abaffa/sol-1/hardware/board-images/20180803_121057.png

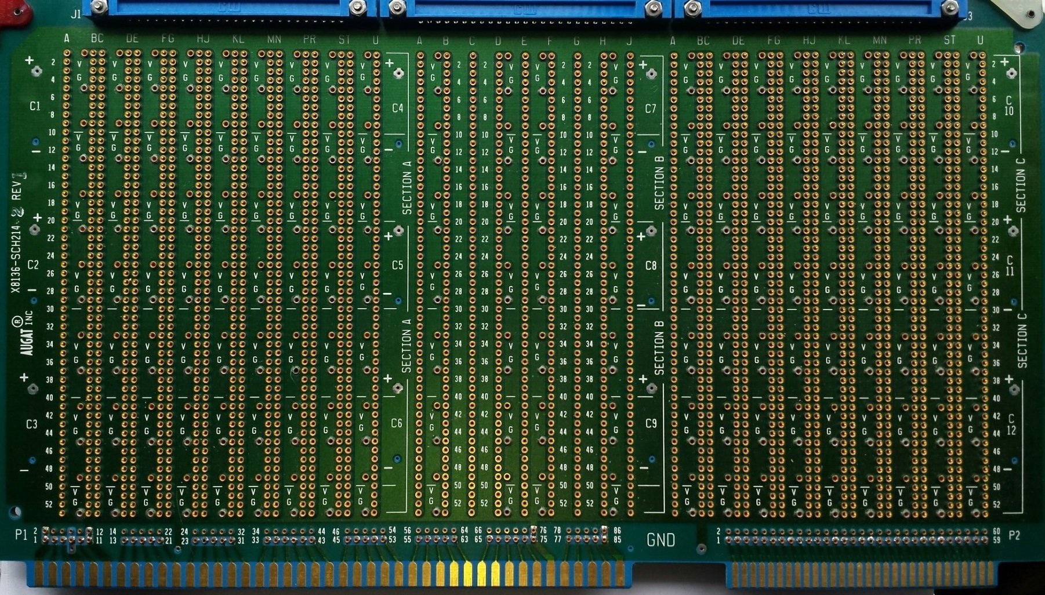
hardware/board-images/20180803_121057.png
