abaffa/sol-1/general_docs/TIL311_BOARD.png

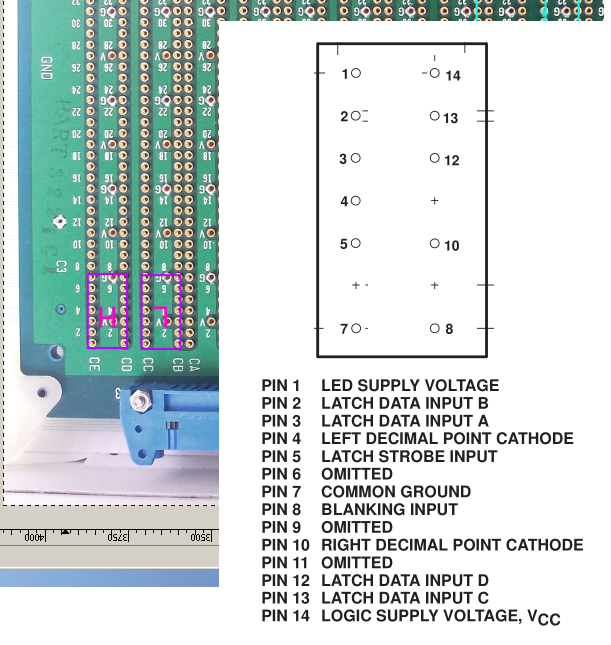
general_docs/TIL311_BOARD.png
