abaffa/sol-1/asciifull.gif

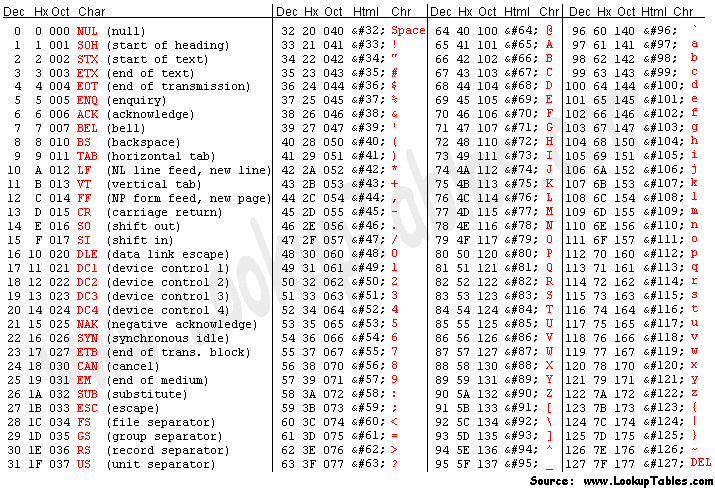
asciifull.gif
