abaffa/sol-1/general_docs/118781455_2642042719341005_6597366256445880285_o.jpg

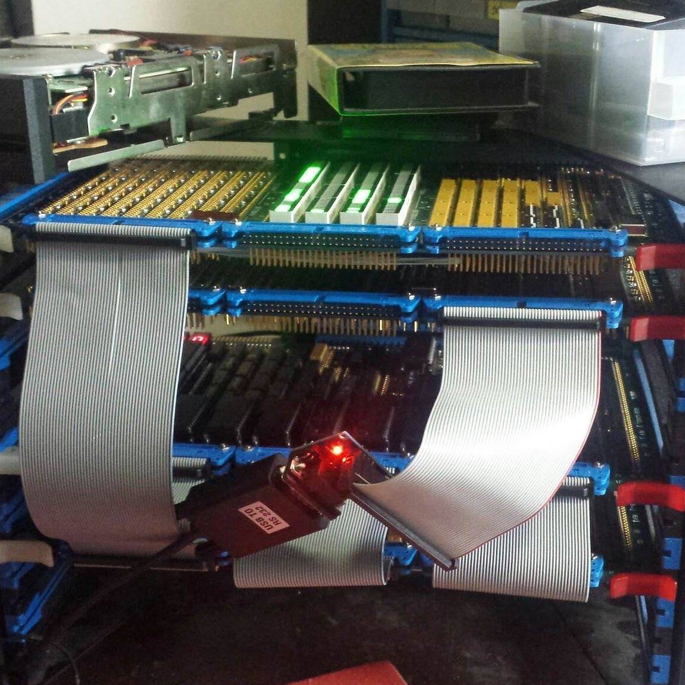
general_docs/118781455_2642042719341005_6597366256445880285_o.jpg
