abaffa/sol-1/general_docs/architecture.png

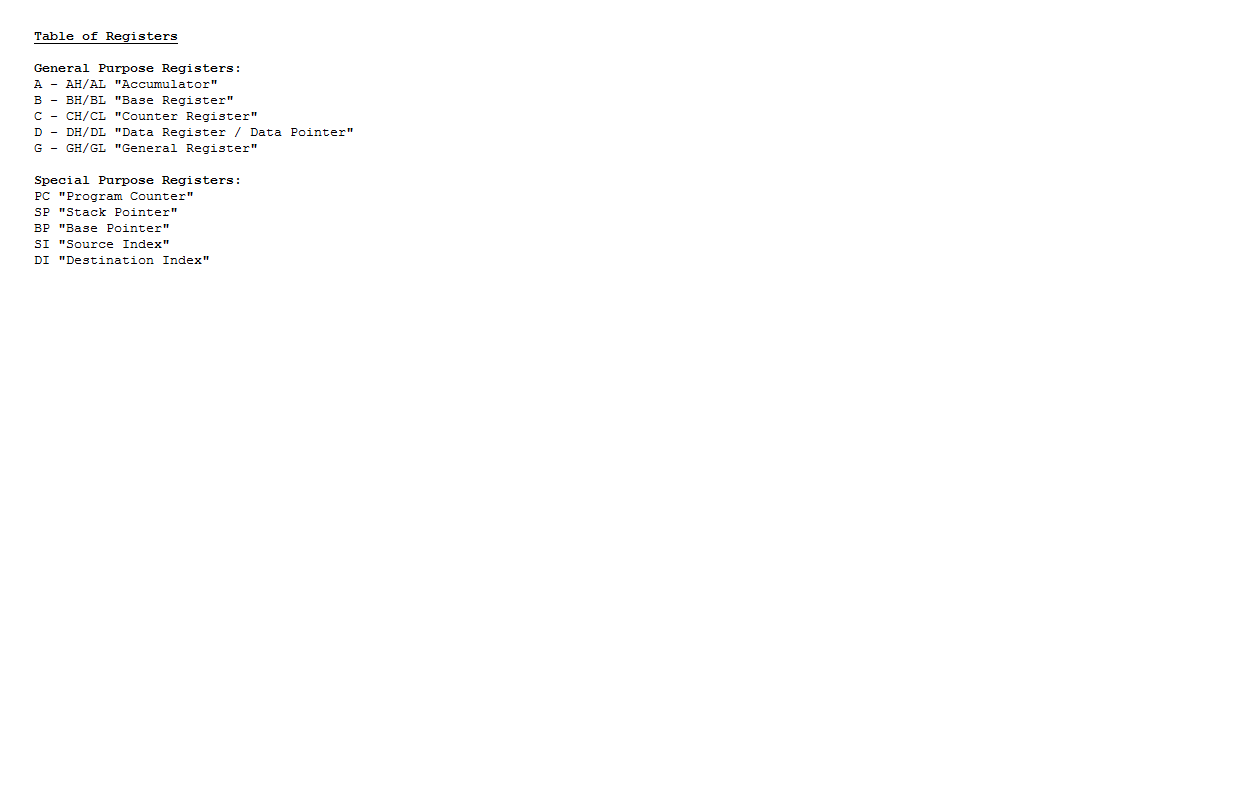
general_docs/architecture.png
