abaffa/sol-1/general_docs/crystal_pinout.png

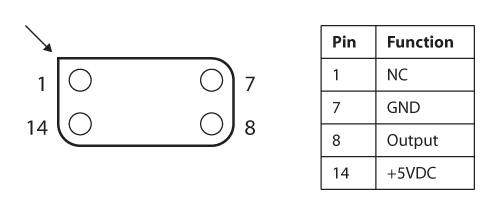
general_docs/crystal_pinout.png
