abaffa/sol-1/general_docs/division1.png

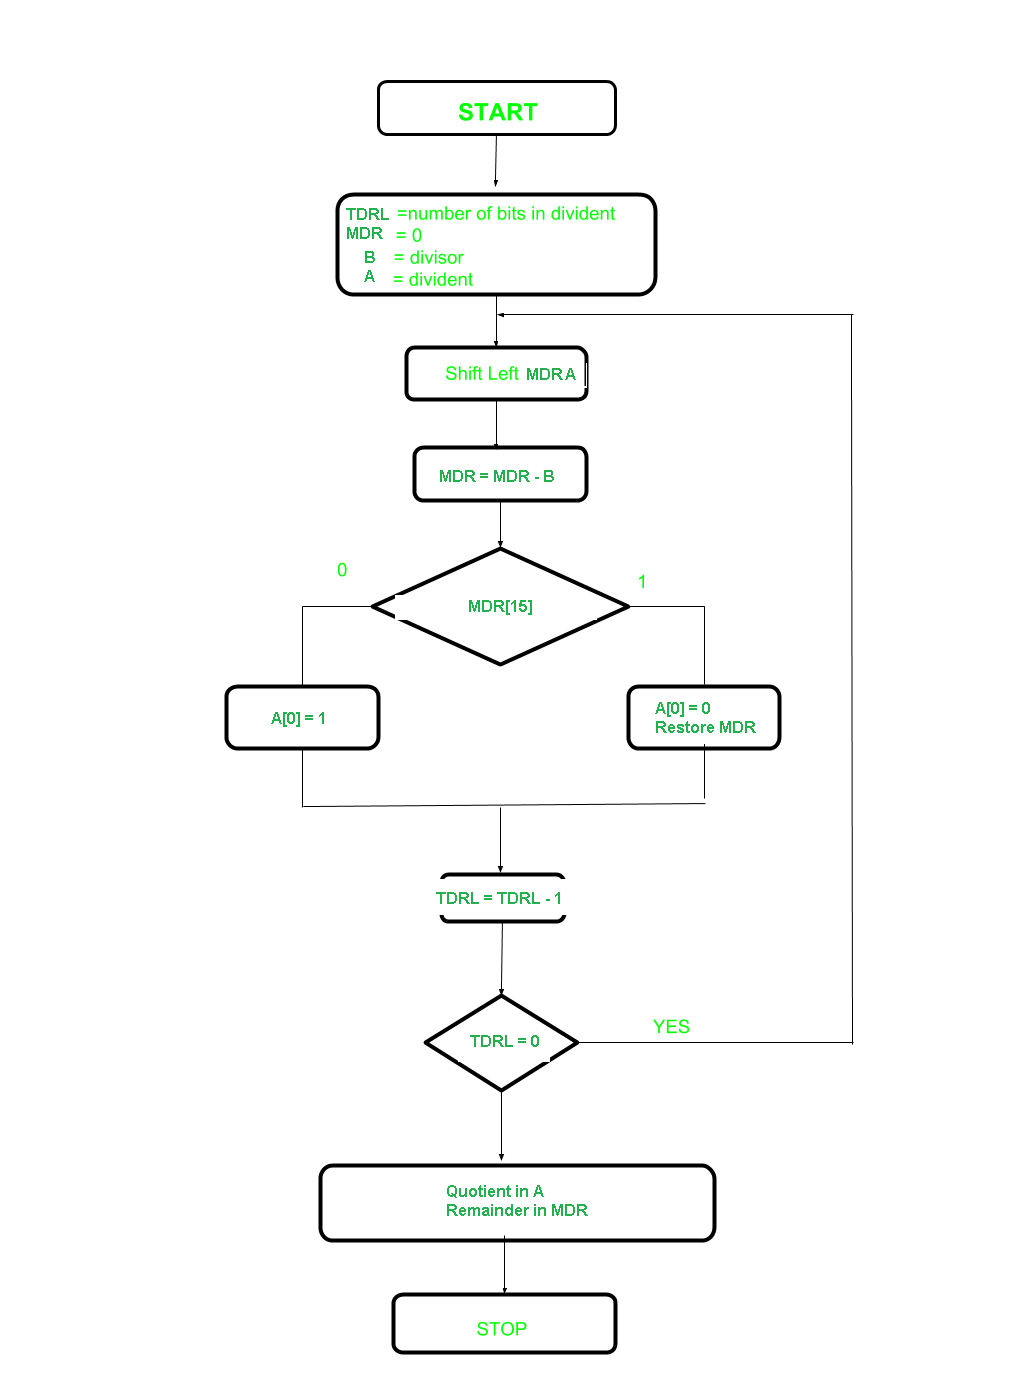
general_docs/division1.png
