abaffa/sol-1/general_docs/Introduction-to-NodeMCU-V3-2-1.png

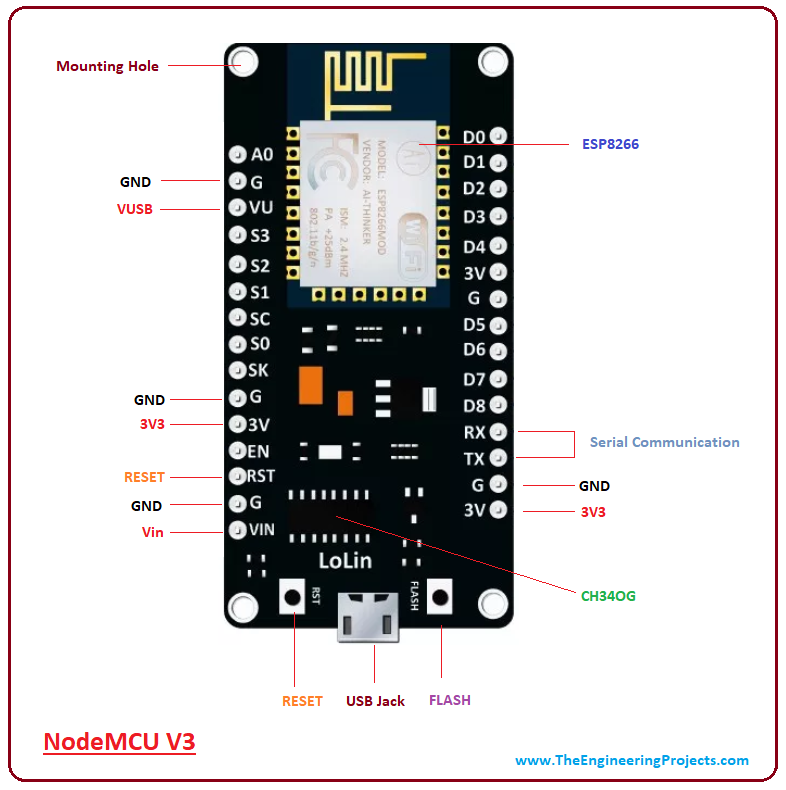
general_docs/Introduction-to-NodeMCU-V3-2-1.png
