abaffa/sol-1/general_docs/isa.jpg

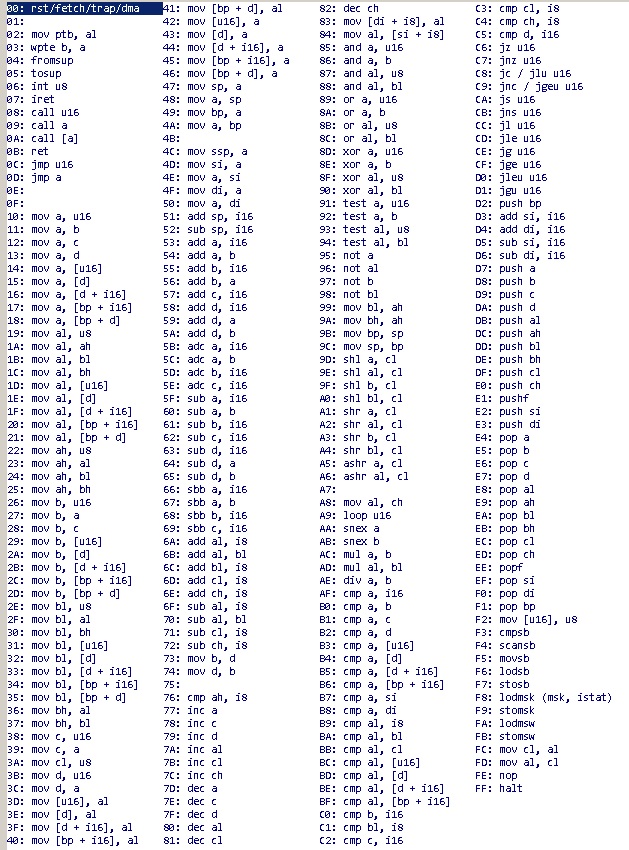
general_docs/isa.jpg
