abaffa/sol-1/general_docs/mc3-io-cf-sch.png

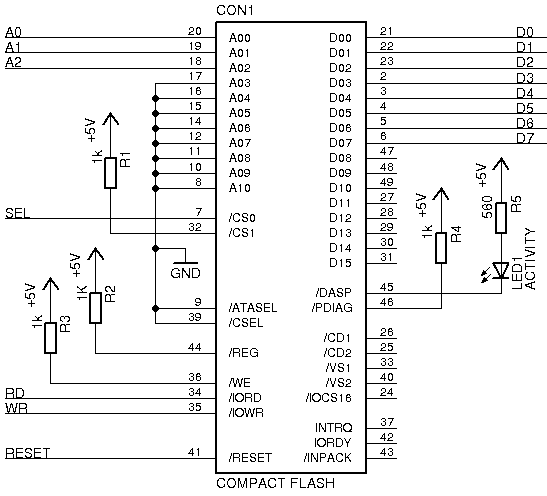
general_docs/mc3-io-cf-sch.png
