abaffa/sol-1/general_docs/PATA.gif

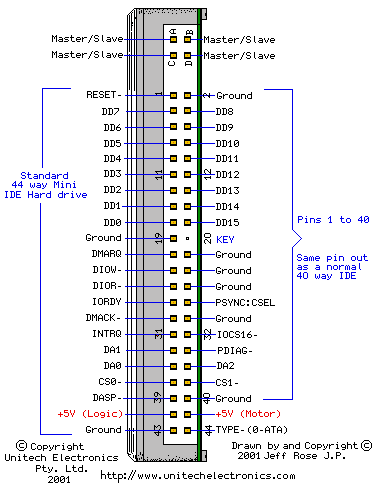
general_docs/PATA.gif
