abaffa/sol-1/general_docs/proxy.jpg

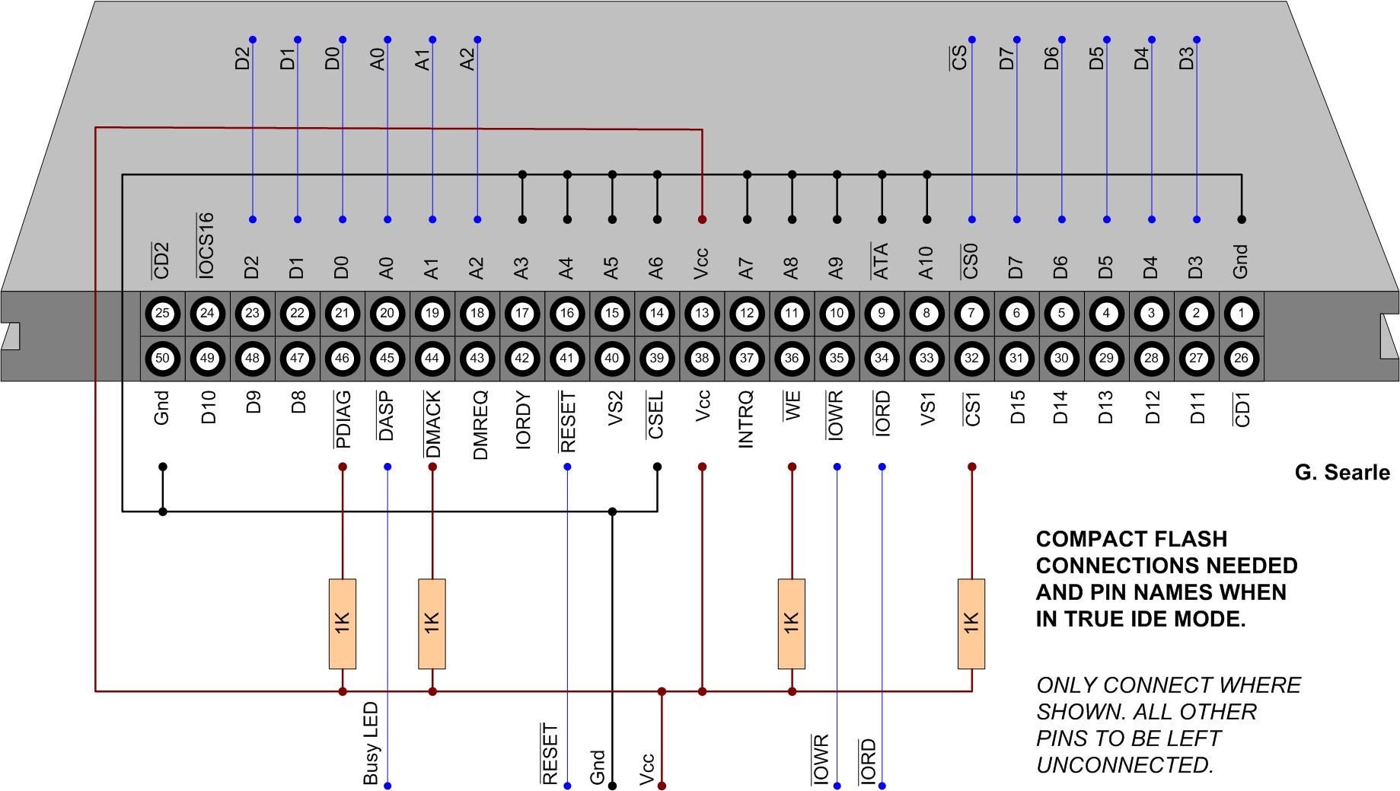
general_docs/proxy.jpg
