abaffa/sol-1/general_docs/qPHwh.jpg

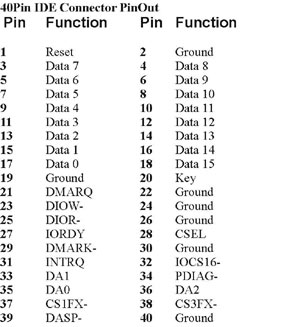
general_docs/qPHwh.jpg
