abaffa/sol-1/general_docs/sanyo_mainboard.jpg

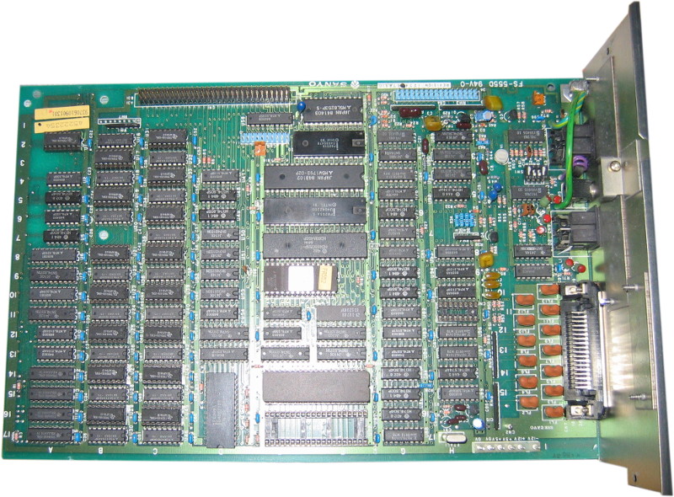
general_docs/sanyo_mainboard.jpg
