abaffa/sol-1/general_docs/TIL311.png

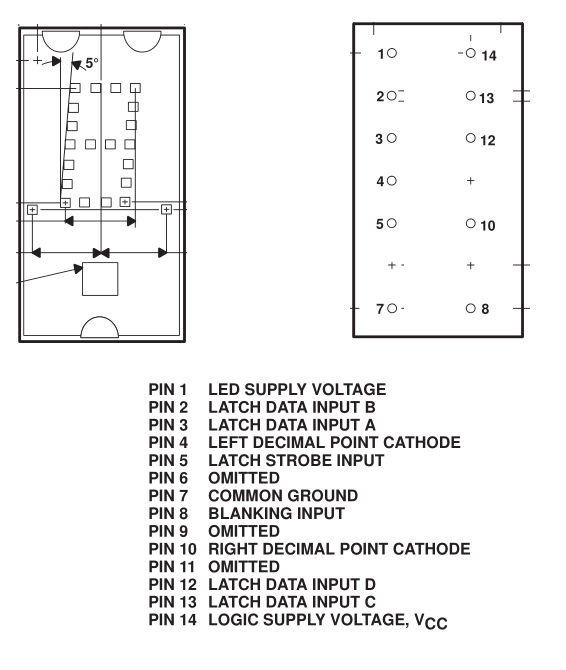
general_docs/TIL311.png
