abaffa/sol-1/general_docs/VIDEO/20060827t180501-videogen.png

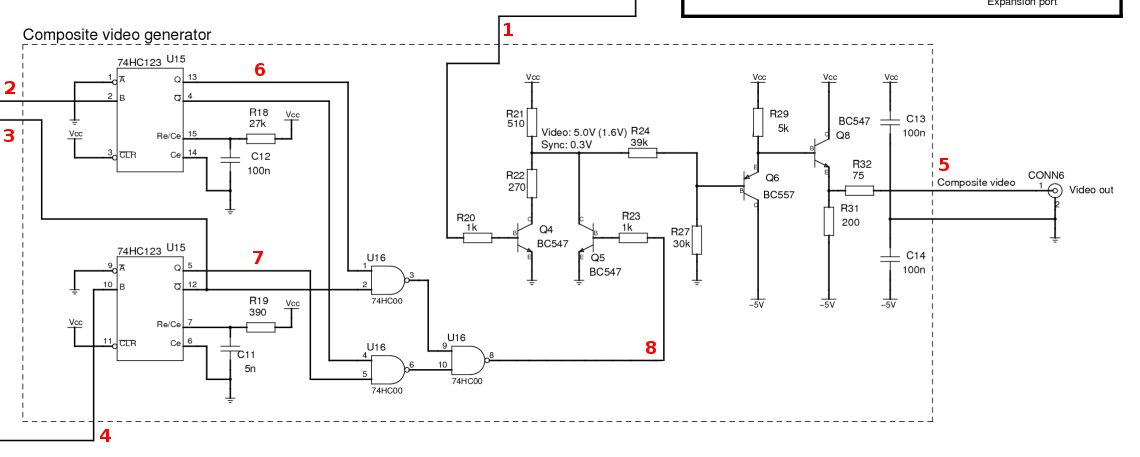
general_docs/VIDEO/20060827t180501-videogen.png
