abaffa/sol-1/general_docs/VIDEO/CBS-Color-FCC-Waveforms.jpg

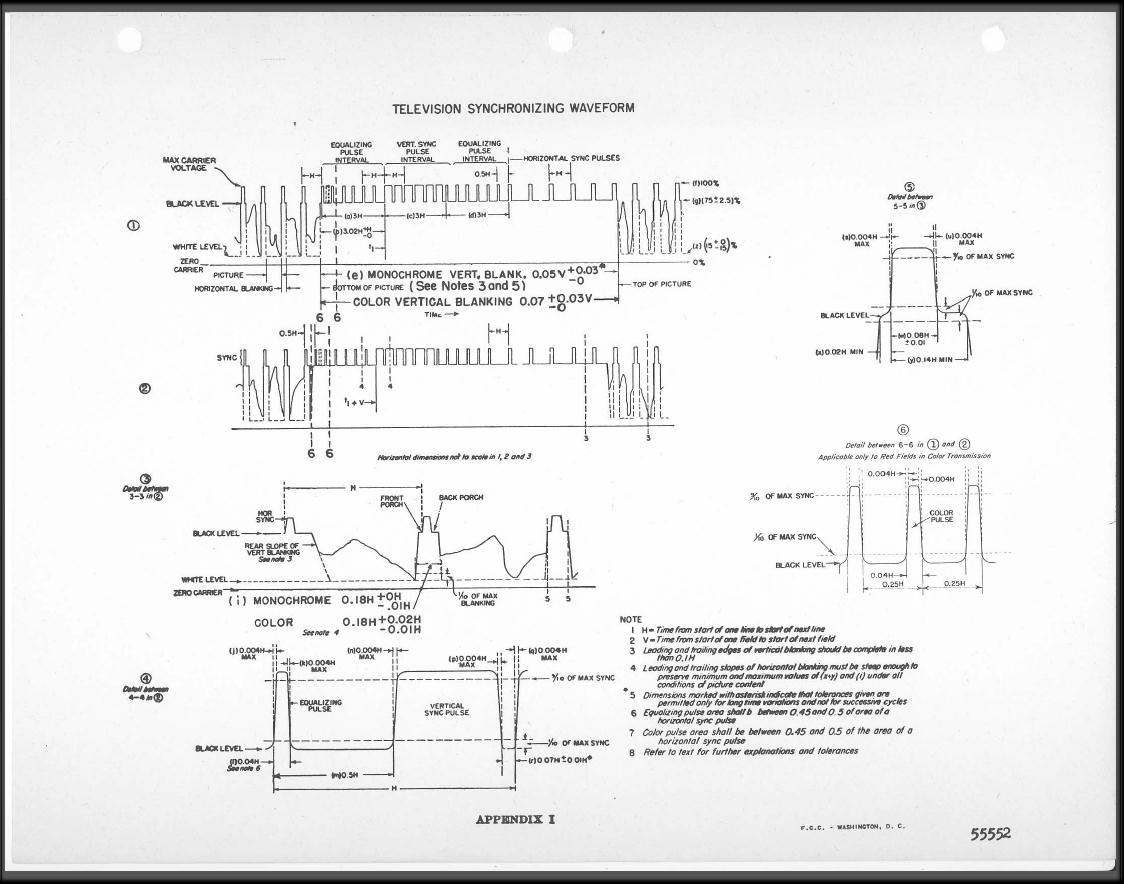
general_docs/VIDEO/CBS-Color-FCC-Waveforms.jpg
