abaffa/sol-1/general_docs/VIDEO/f19f8d1a1010.gif

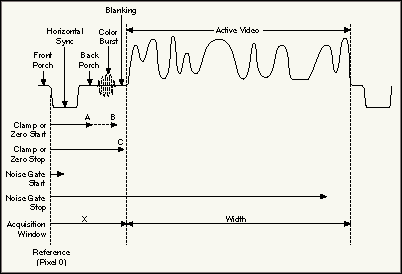
general_docs/VIDEO/f19f8d1a1010.gif
