abaffa/sol-1/general_docs/VIDEO/mc3-video-part1.png

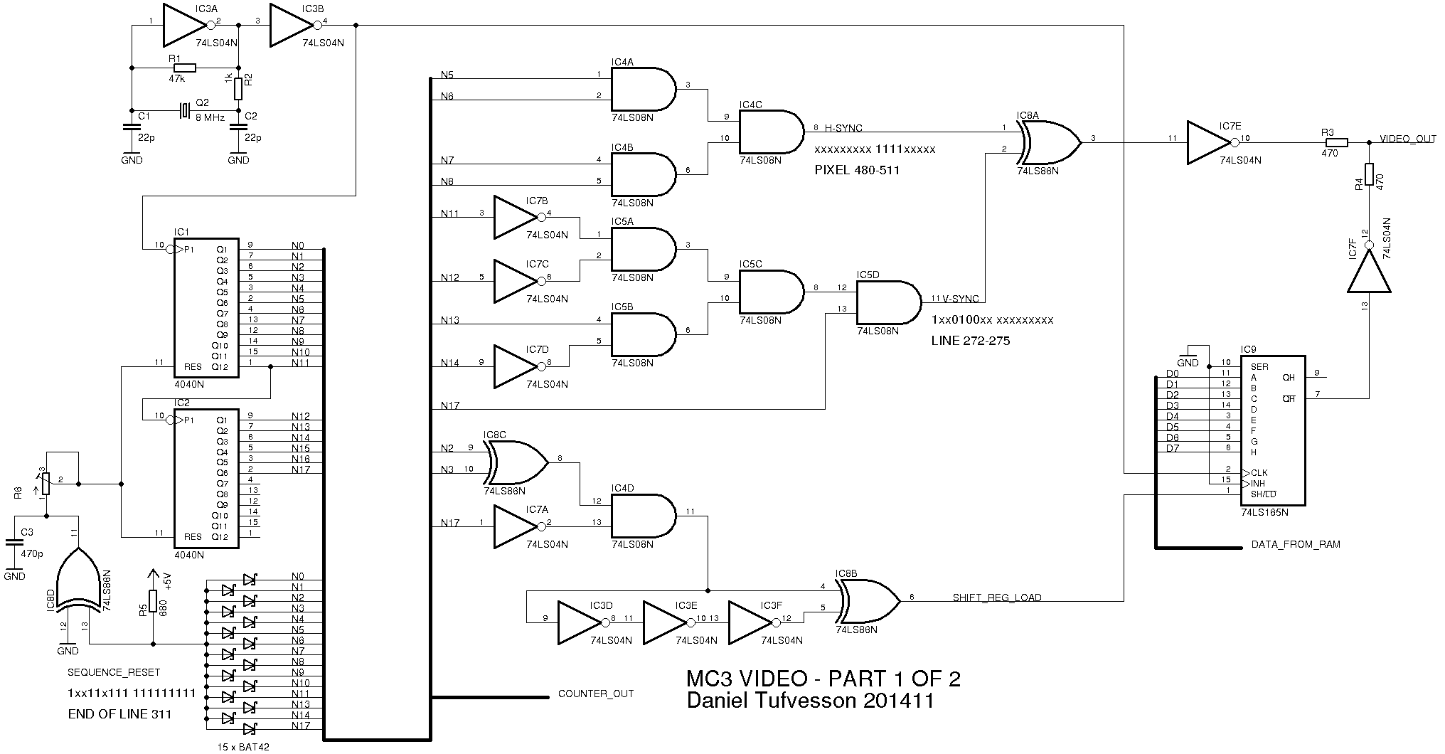
general_docs/VIDEO/mc3-video-part1.png
