abaffa/sol-1/general_docs/VIDEO/mc3-video-part2.png

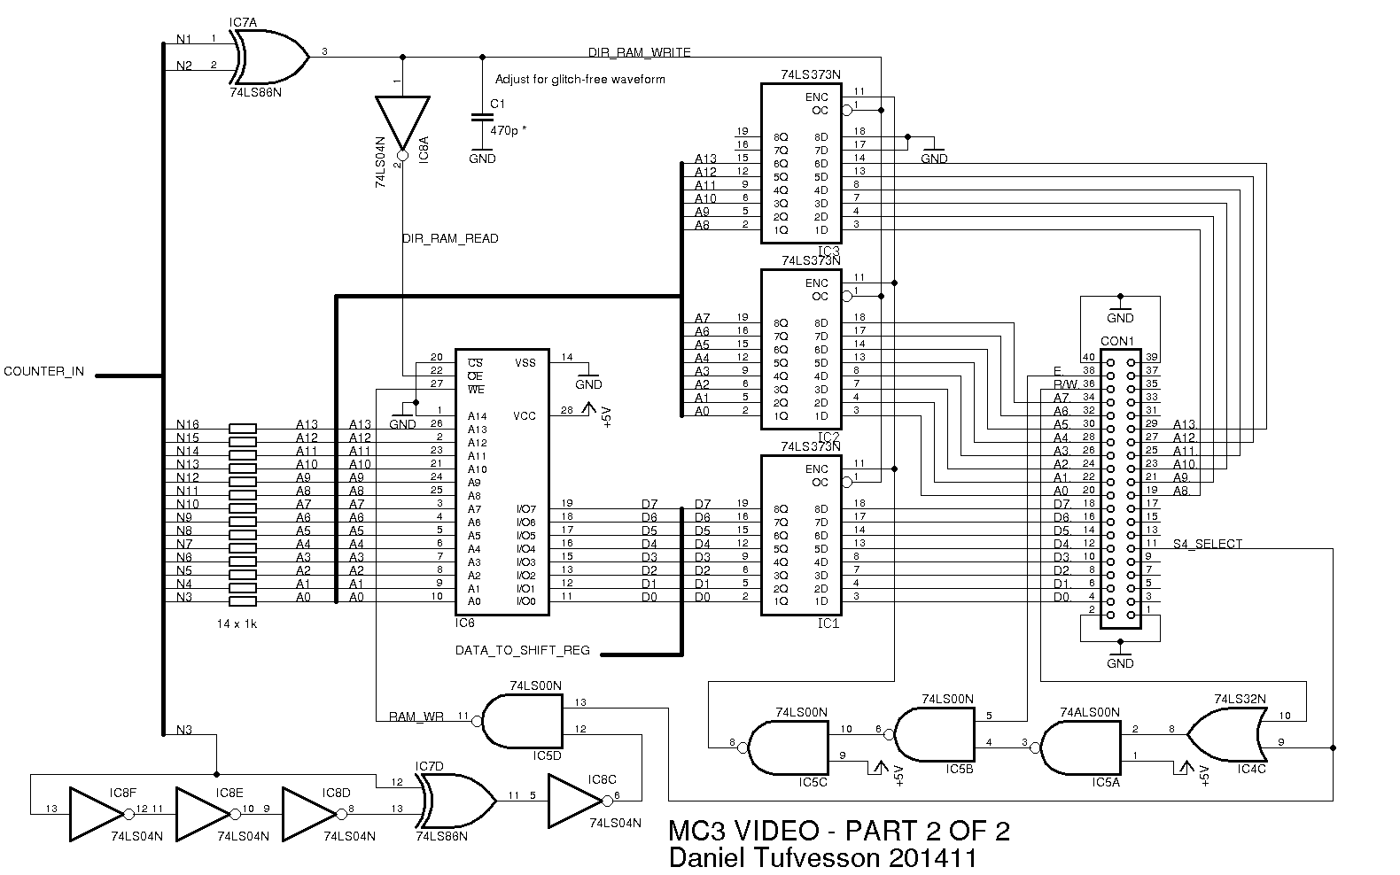
general_docs/VIDEO/mc3-video-part2.png
