abaffa/sol-1/general_docs/VIDEO/mc3-video-screen2.jpg

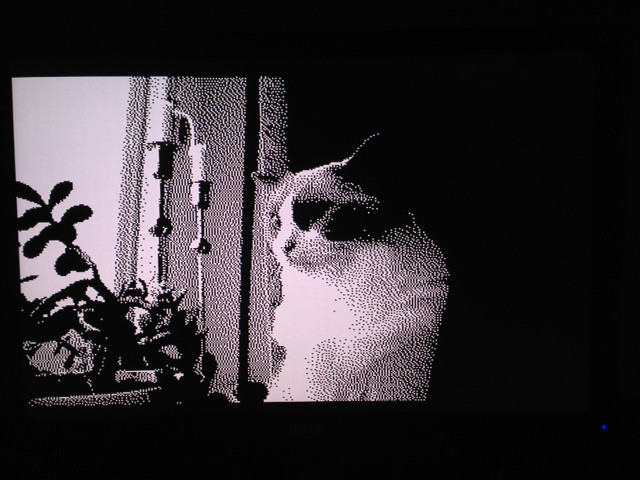
general_docs/VIDEO/mc3-video-screen2.jpg
