abaffa/sol-1/general_docs/VIDEO/RS-170A.gif

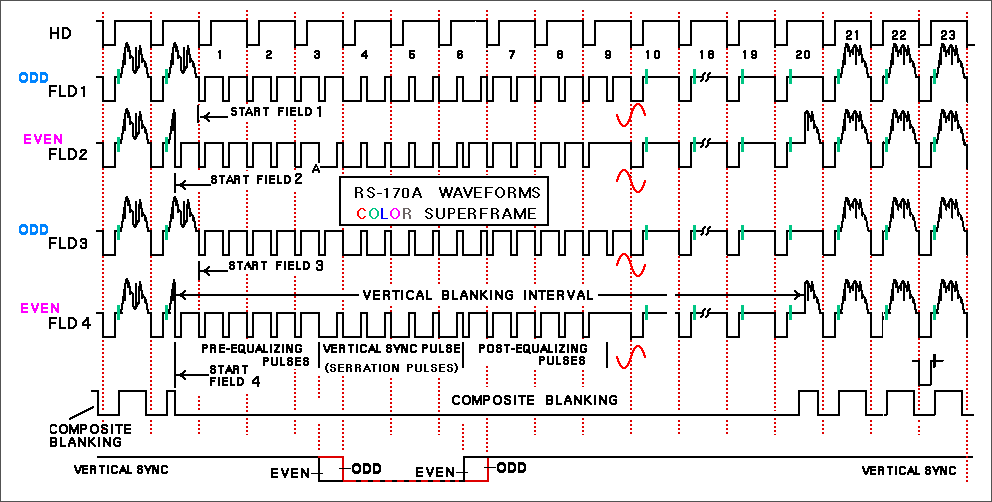
general_docs/VIDEO/RS-170A.gif
