abaffa/sol-1/general_docs/VIDEO/schema.jpg

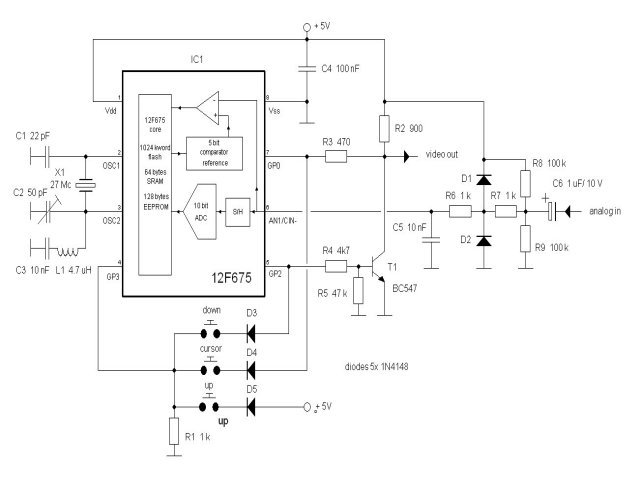
general_docs/VIDEO/schema.jpg
