abaffa/sol-1/general_docs/VIDEO/Timing_PAL_FrameSignal_Progressive.gif

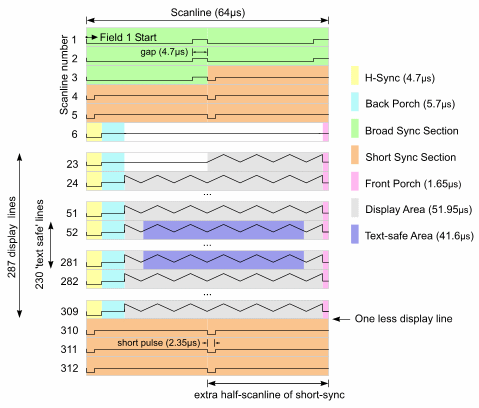
general_docs/VIDEO/Timing_PAL_FrameSignal_Progressive.gif
