abaffa/sol-1/general_docs/VIDEO/upload_2017-1-2_23-47-19.png

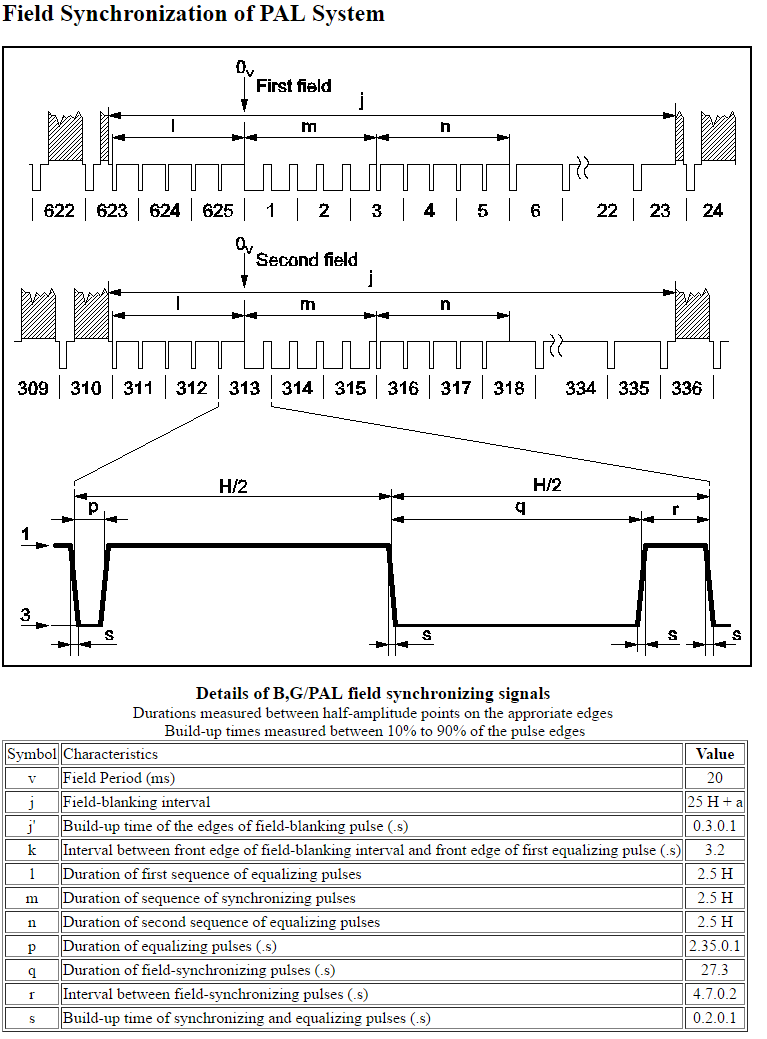
general_docs/VIDEO/upload_2017-1-2_23-47-19.png
