abaffa/sol-1/general_docs/VIDEO/vsync-full.png

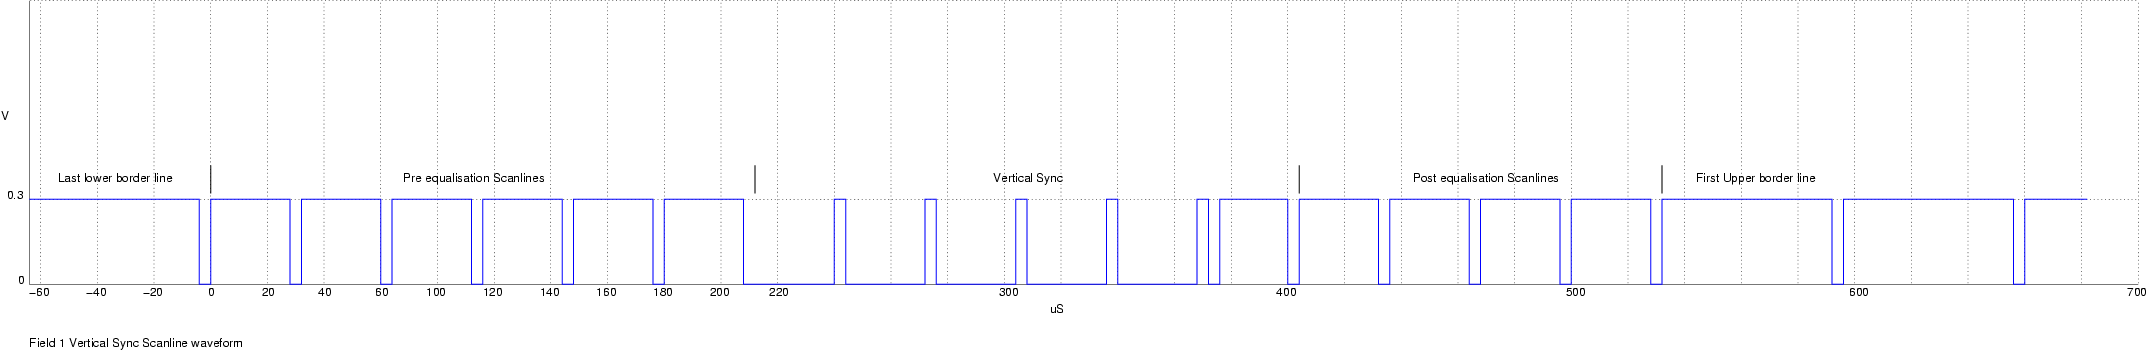
general_docs/VIDEO/vsync-full.png
