abaffa/sol-1/sol1_docs/CPU_Architecture.png

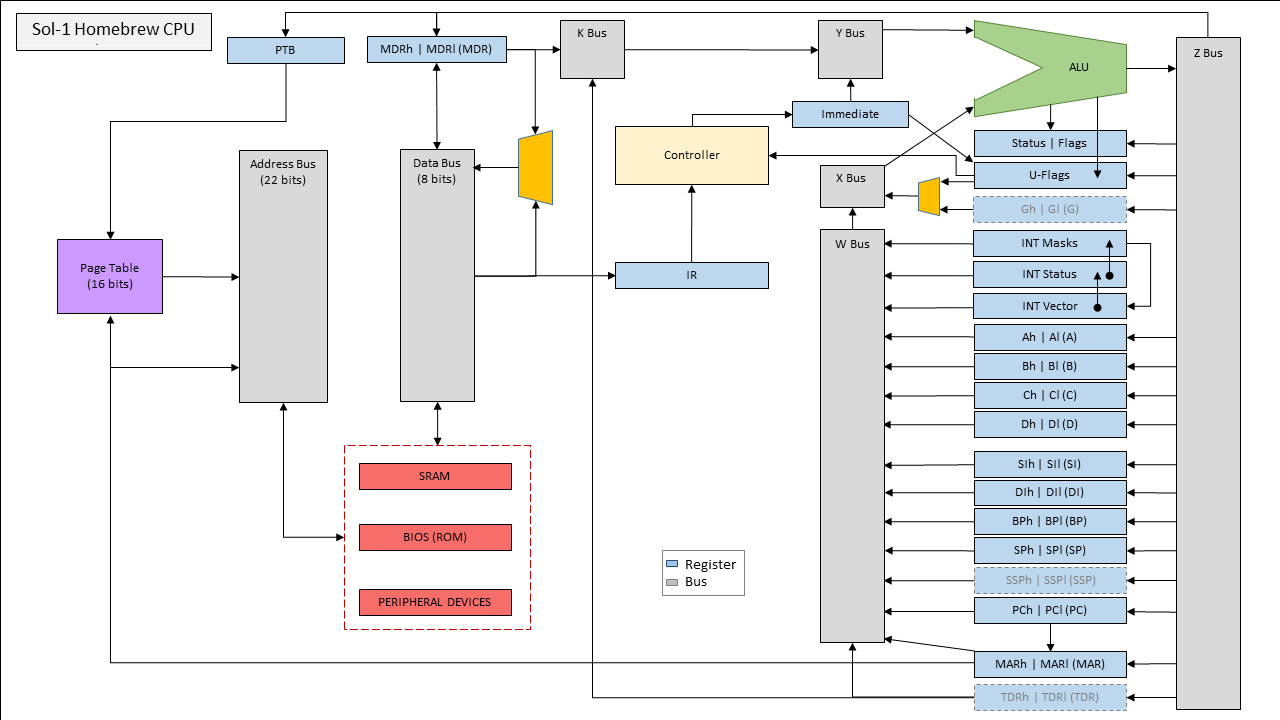
sol1_docs/CPU_Architecture.png
