abaffa/sol-1/sol1_docs/microcode_compiler.png

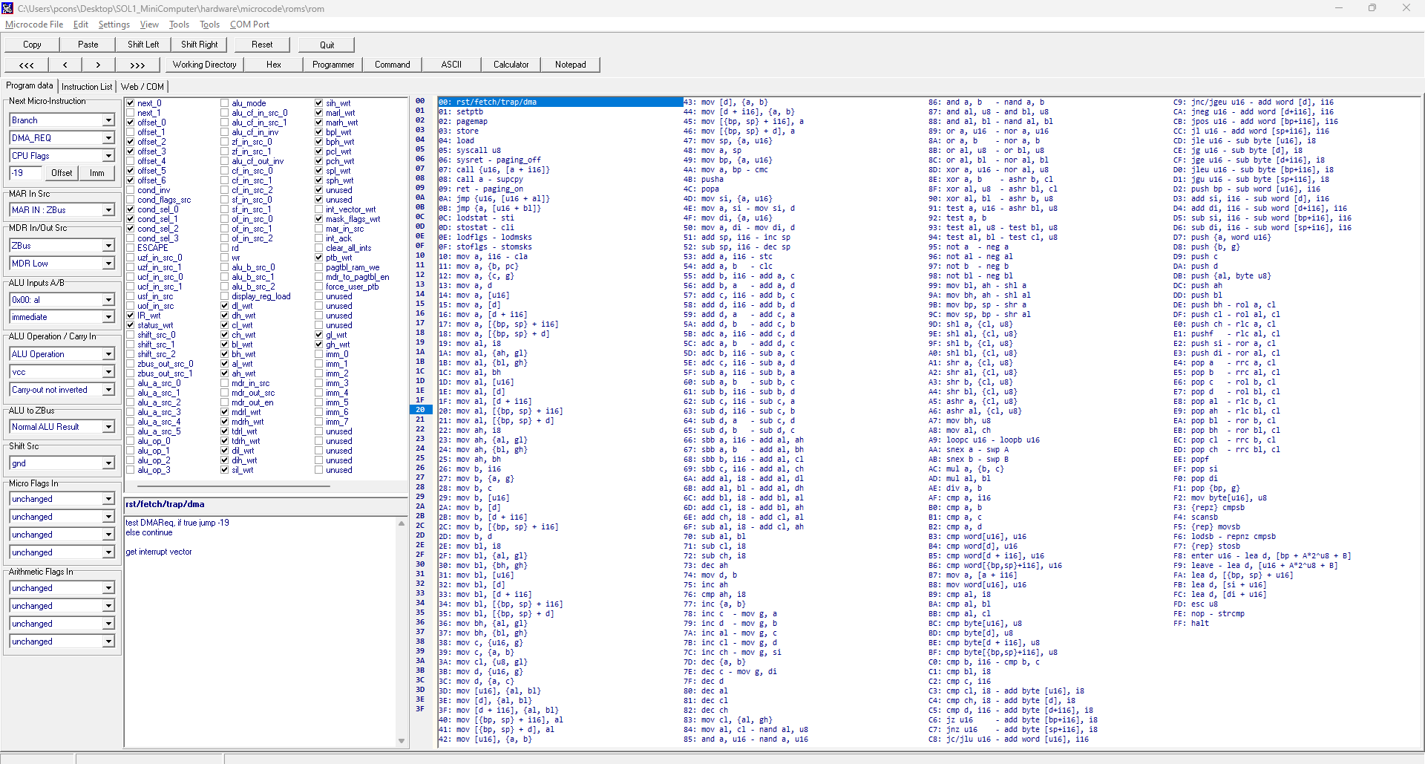
sol1_docs/microcode_compiler.png
