abaffa/sol-1/(list of files, cad)

Other CAD files:
ccompiler/a.obj
hardware/microcode/find.obj
hardware/microcode/simu.obj
hardware/microcode/sim.obj
hardware/microcode/unit_prompt.obj
hardware/microcode/class.obj
hardware/microcode/cf.obj
hardware/microcode/u_code_compiler_defs.obj
hardware/microcode/options.obj
