abaffa/sol-1/hardware/schematics/main.sch

## EAGLE design hardware/schematics/main.sch (2023-01-07)

Schematic: main.sch

Parts:
DIS1, DIS2, DIS3, DIS4, DIS5, DIS6: HTIL311A
FLAGS: 74273N; DIL20
IC1, IC13, IC15, IC39, IC90, IC98, IC104, IC112, IC114, IC118, IC121, IC122, IC125, IC127, IC142, IC147, IC195, IC206, IC256, IC341: 74LS257N; DIL16
IC2, IC3, IC5, IC6, IC9, IC12, IC14, IC16, IC20, IC23, IC30, IC41, IC42, IC44, IC53, IC56, IC61, IC62, IC67, IC68, IC69, IC71, IC80, IC81, IC82, IC84, IC85, IC86, IC87, IC88, IC89, IC130, IC133, IC141, IC144, IC152, IC160: 74LS151N; DIL16
IC4, IC26, IC65, IC70, IC72, IC97, IC120, IC161, IC163, IC185, IC207, IC209, IC211: 74LS244N; DIL20
IC7, IC24, IC54, IC96, IC128, IC129, IC131, IC132: 74157N; DIL16
IC8, IC19, IC28, IC31, IC48, IC57, IC66, IC99, IC101, IC102, IC106, IC109, IC110, IC117, IC123, IC157, IC158, IC159, IC162, IC165, IC166, IC169, IC171, IC172, IC177, IC178, IC183, IC184, IC198, IC204, IC210, IC245, IC260: 74LS377N; DIL20
IC10, IC11: 74S181N; DIL24-6
IC17, IC27, IC150, IC218, IC219, IC222, IC223, IC224, IC225, IC228, IC229, IC230: 74HC244N; DIL20
IC18, IC221, IC251: 74S32N; DIL14
IC21, IC140: 58C256P; DIL28-6
IC22, IC143, IC146, IC201, IC233, IC240, IC242, IC244: 74LS08N; DIL14
IC25, IC173, IC202, IC232: 74LS27N; DIL14
IC29, IC34, IC35, IC36, IC37, IC38, IC40, IC47, IC64, IC73, IC83, IC92, IC103, IC116, IC124, IC180, IC237, IC241, IC255, IC270: 74S153N; DIL16
IC32, IC33, IC60, IC75, IC76, IC77, IC78, IC79, IC134, IC135, IC136, IC231, IC250, IC334, IC336, IC338: 74273N; DIL20
IC43, IC115, IC138, IC154, IC155, IC156, IC176, IC205, IC216, IC217, IC234, IC238, IC239, IC246, IC248, IC253: 74LS04N; DIL14
IC45, IC93, IC119, IC236: 74S08N; DIL14
IC46, IC50, IC51, IC52: 74LS283N; DIL16
IC49, IC55, IC63, IC100: 74S257N; DIL16
IC58: 74LS11N; DIL14
IC59, IC175: 7486N; DIL14
IC74, IC107, IC108, IC126, IC137, IC190, IC191, IC200: 74LS74N; DIL14
IC91, IC95, IC111, IC113, IC170, IC179, IC181, IC182: 74LS253N; DIL16
IC94, IC151, IC153, IC167, IC174: 7432N; DIL14; MPN SN7432N
IC105: 74LS148N; DIL16
IC139, IC148, IC226, IC247: 74LS00N; DIL14
IC145: 7410N; DIL14
IC149, IC164, IC214, IC254: 74LS138N; DIL16
IC168: 74LS20N; DIL14
IC186, IC189: 4040N; DIL16
IC187, IC213: 431000; DIL32
IC188, IC199, IC212, IC227, IC243, IC257, IC261, IC262, IC302, IC303, IC333, IC335, IC337, IC339: 27512; DIL28
IC192, IC193, IC194, IC411: 74279N; DIL16
IC196, IC197: 7404N; DIL14
IC203: 74LS30N; DIL14
IC208: 74LS245N; DIL20
IC215, IC220, IC235, IC249, IC252: 74LS02N; DIL14
IC263: 74LS32N; DIL14
IC412: 74LS173N; DIL16
IC_02_0: 7402N; DIL14
IC_04_2: 74HC04N; DIL14
IC_10_0: 74LS10N; DIL14
IC_86_0, IC_86_1: 74LS86N; DIL14
INT_CODE_REG1: 74LS377N; DIL20
INT_STATUS_REG: 74273N; DIL20
R1, R2, R3, R4, R5, R6, R7, R8, R9, R10, R11, R12, R13, R14, R15, R16, R17, R18, R19, R20, R21, R22, R23, R24, R25, R26, R27, R28: R-US_0204/2V; 0204V
S5, S7, S8: TL36PO; TL3XPO
SW1, SW2, SW3, SW4, SW5: SW_DIP-8; EDG-08
U1, U2, U3, U4, U5, U6, U7, U8: AS6C4008-55PCN; DIP254P1524X393-32

Connections:
1: IC15.4 (1Y), IC61.4 (D0), IC153.5 (I1), IC167.5 (I1)
1KHZ: SW3.6
1MHZ: SW3.7
2: IC15.7 (2Y), IC61.3 (D1), IC167.4 (I0)
2MHZ: SW3.8
3: IC15.9 (3Y), IC59.4 (I0), IC61.2 (D2)
4: IC15.12 (4Y), IC59.5 (I1), IC61.1 (D3)
10HZ: SW3.2
50HZ: SW3.3
200HZ: SW3.4
500HZ: SW3.5
2345: IC42.9 (C), IC125.9 (3Y)
234324: IC125.12 (4Y), IC180.14 (A)
423423: IC118.4 (1Y), IC180.2 (B)
AD0: IC4.18 (Y1)
AD1: IC4.16 (Y2)
AD2: IC4.14 (Y3)
AD3: IC4.12 (Y4)
AD4: IC4.9 (Y1)
AD5: IC4.7 (Y2)
AD6: IC4.5 (Y3)
AD7: IC4.3 (Y4)
AD8: IC26.18 (Y1)
AD9: IC26.16 (Y2)
AD10: IC26.14 (Y3)
AD11: IC26.12 (Y4)
AD12: IC26.9 (Y1)
AD13: IC26.7 (Y2)
AD14: IC26.5 (Y3)
AD15: IC26.3 (Y4)
AD16: IC65.18 (Y1)
AD17: IC65.16 (Y2)
AD18: IC65.14 (Y3)
AD19: IC65.12 (Y4)
AD20: IC65.9 (Y1)
AD21: IC65.7 (Y2)
ADDRESS_BUS0: IC207.2 (A1), IC223.18 (Y1)
ADDRESS_BUS1: IC207.4 (A2), IC223.16 (Y2)
ADDRESS_BUS2: IC207.6 (A3)
ADDRESS_BUS3: IC207.8 (A4)
ADDRESS_BUS4: IC207.11 (A1)
ADDRESS_BUS5: IC207.13 (A2)
ADDRESS_BUS6: IC207.15 (A3)
ADDRESS_BUS7: IC207.17 (A4)
ADDRESS_BUS8: IC209.2 (A1)
ADDRESS_BUS9: IC209.4 (A2)
ADDRESS_BUS10: IC209.6 (A3)
ADDRESS_BUS11: IC209.8 (A4)
ADDRESS_BUS12: IC209.11 (A1)
ADDRESS_BUS13: IC209.13 (A2)
ADDRESS_BUS14: IC209.15 (A3)
ADDRESS_BUS15: IC209.17 (A4)
ADDRESS_BUS16: IC211.2 (A1)
ADDRESS_BUS17: IC211.4 (A2)
ADDRESS_BUS18: IC211.6 (A3)
ADDRESS_BUS19: IC211.8 (A4)
ADDRESS_BUS20: IC211.11 (A1)
ADDRESS_BUS21: IC211.13 (A2), IC229.16 (Y2)
ADDR_13: IC214.1 (A)
ADDR_14: IC214.2 (B)
ADDR_15: IC232.5 (I2), IC246.13 (I)
AH_0: IC3.3 (D1)
AH_1: IC6.3 (D1)
AH_2: IC41.3 (D1)
AH_3: IC56.3 (D1)
AH_4: IC68.3 (D1)
AH_5: IC81.3 (D1)
AH_6: IC85.3 (D1)
AH_7: IC88.3 (D1)
ALU_A_SRC_0: IC125.3 (1B)
ALU_A_SRC_1: IC125.6 (2B)
ALU_A_SRC_2: IC125.10 (3B)
ALU_A_SRC_3: IC83.14 (A), IC125.13 (4B)
ALU_A_SRC_4: IC83.2 (B), IC118.3 (1B)
ALU_A_SRC_5: IC1.1 (!A!/B), IC13.1 (!A!/B)
ALU_B_SRC_0: IC92.14 (A)
ALU_B_SRC_1: IC92.2 (B)
ALU_B_SRC_2: IC98.1 (!A!/B), IC122.1 (!A!/B)
ALU_CF: IC11.16 (CN+4), IC_86_0.5 (I1)
ALU_CF_IN_INVERT: IC_86_0.2 (I1)
ALU_CF_IN_SRC_0: IC47.14 (A)
ALU_CF_IN_SRC_1: IC47.2 (B)
ALU_CF_OUT_INVERT: IC_86_0.4 (I0)
ALU_FINAL_CF: IC14.3 (D1), IC270.5 (1C1), IC_86_0.6 (O)
ALU_MODE: IC10.8 (M), IC11.8 (M)
ALU_OF: IC23.3 (D1), IC127.3 (1B), IC_04_2.4 (O)
ALU_OP0: IC10.6 (S0), IC11.6 (S0), IC_10_0.1 (I0)
ALU_OP1: IC10.5 (S1), IC11.5 (S1), IC_02_0.3 (I1)
ALU_OP2: IC10.4 (S2), IC11.4 (S2), IC_02_0.2 (I0)
ALU_OP3: IC10.3 (S3), IC11.3 (S3), IC_10_0.2 (I1)
ALU_OUTPUT_0: IC10.9 (F0), IC14.2 (D2), IC16.1 (D3), IC91.6 (1C0), IC91.12 (2C2), IC270.4 (1C2)
ALU_OUTPUT_1: IC10.10 (F1), IC91.5 (1C1), IC91.10 (2C0), IC95.4 (1C2)
ALU_OUTPUT_2: IC10.11 (F2), IC91.11 (2C1), IC95.6 (1C0), IC95.12 (2C2)
ALU_OUTPUT_3: IC10.13 (F3), IC95.5 (1C1), IC95.10 (2C0), IC111.4 (1C2)
ALU_OUTPUT_4: IC11.9 (F0), IC95.11 (2C1), IC111.6 (1C0), IC111.12 (2C2)
ALU_OUTPUT_5: IC11.10 (F1), IC111.5 (1C1), IC111.10 (2C0), IC113.4 (1C2)
ALU_OUTPUT_6: IC11.11 (F2), IC111.11 (2C1), IC113.6 (1C0), IC113.12 (2C2)
ALU_OUTPUT_7: IC11.13 (F3), IC14.15 (D4), IC16.15 (D4), IC91.3 (1C3), IC91.13 (2C3), IC95.3 (1C3), IC95.13 (2C3), IC111.3 (1C3), IC111.13 (2C3), IC113.3 (1C3), IC113.5 (1C1), IC113.10 (2C0), IC113.13 (2C3), IC270.3 (1C3)
ALU_ZF: IC58.3 (I0), IC58.12 (O), IC236.1 (I0), IC237.5 (1C1), IC241.5 (1C1)
AL_0: IC3.4 (D0)
AL_1: IC6.4 (D0)
AL_2: IC41.4 (D0)
AL_3: IC56.4 (D0)
AL_4: IC68.4 (D0)
AL_5: IC81.4 (D0)
AL_6: IC85.4 (D0)
AL_7: IC88.4 (D0)
ANY_INTERRUPTION: IC18.6 (O), IC119.2 (I1)
A_WRT: IC165.1 (G), IC171.1 (G)
BH_0: IC3.1 (D3)
BH_1: IC6.1 (D3)
BH_2: IC41.1 (D3)
BH_3: IC56.1 (D3)
BH_4: IC68.1 (D3)
BH_5: IC81.1 (D3)
BH_6: IC85.1 (D3)
BH_7: IC88.1 (D3)
BIOS_CONFIG: IC254.7 (Y7)
BL_0: IC3.2 (D2)
BL_1: IC6.2 (D2)
BL_2: IC41.2 (D2)
BL_3: IC56.2 (D2)
BL_4: IC68.2 (D2)
BL_5: IC81.2 (D2)
BL_6: IC85.2 (D2)
BL_7: IC88.2 (D2)
BPH_WRT: IC123.1 (G)
BPL_WRT: IC117.1 (G)
BP_H_0: IC2.1 (D3)
BP_H_1: IC20.1 (D3)
BP_H_2: IC44.1 (D3)
BP_H_3: IC62.1 (D3)
BP_H_4: IC69.1 (D3)
BP_H_5: IC82.1 (D3)
BP_H_6: IC86.1 (D3)
BP_H_7: IC89.1 (D3)
BP_L_0: IC2.2 (D2)
BP_L_1: IC20.2 (D2)
BP_L_2: IC44.2 (D2)
BP_L_3: IC62.2 (D2)
BP_L_4: IC69.2 (D2)
BP_L_5: IC82.2 (D2)
BP_L_6: IC86.2 (D2)
BP_L_7: IC89.2 (D2)
BUFFER_MEM_IO: IC161.14 (Y3), IC164.4 (G2A), IC164.5 (G2B), IC168.1 (I0), IC205.5 (I), IC214.6 (G1), IC_10_0.11 (I2)
BUFFER_RD: IC161.18 (Y1), IC187.24 (!OE), IC188.22 (!OE), IC208.1 (DIR), U1.24 (OE), U2.24 (OE), U3.24 (OE), U4.24 (OE), U5.24 (OE), U6.24 (OE), U7.24 (OE), U8.24 (OE)
BUFFER_RD_MEMORY: IC161.12 (Y4)
BUFFER_WR: IC161.16 (Y2), IC187.29 (!WE), U1.29 (WE), U2.29 (WE), U3.29 (WE), U4.29 (WE), U5.29 (WE), U6.29 (WE), U7.29 (WE), U8.29 (WE)
BUFFER_WR_MEMORY: IC161.9 (Y1)
BUS_MEM_IO: IC27.14 (Y3), IC65.5 (Y3), IC161.6 (A3)
BUS_RD: IC27.18 (Y1), IC150.18 (Y1), IC161.2 (A1), IC161.8 (A4)
BUS_TRISTATE: IC4.1 (G), IC4.19 (G), IC26.1 (G), IC26.19 (G), IC65.1 (G), IC65.19 (G), IC72.1 (G), IC90.1 (!A!/B), IC150.1 (G), IC151.6 (O), IC154.9 (I), IC174.6 (O), IC176.9 (I), IC195.1 (!A!/B), IC202.1 (I0)
BUS_WR: IC27.16 (Y2), IC150.16 (Y2), IC161.4 (A2), IC161.11 (A1)
B_WRT: IC166.1 (G)
CF_IN_SRC_0: IC14.11 (A)
CF_IN_SRC_1: IC14.10 (B)
CF_IN_SRC_2: IC14.9 (C)
CH_0: IC3.14 (D5)
CH_1: IC6.14 (D5)
CH_2: IC41.14 (D5)
CH_3: IC56.14 (D5)
CH_4: IC68.14 (D5)
CH_5: IC81.14 (D5)
CH_6: IC85.14 (D5)
CH_7: IC88.14 (D5)
CLEAR_ALL_INTS: IC196.3 (I)
CLK: IC8.11 (CLK), IC32.11 (CLK), IC33.11 (CLK), IC99.11 (CLK), IC120.18 (Y1), IC190.3 (CLK), IC190.11 (CLK)
CLK_2.5HZ: IC189.13 (Q8), SW3.1
CLK_5MHZ: IC186.10 (P1)
CLK_640HZ: IC189.9 (Q1)
CLK_1280HZ: IC186.1 (Q12), IC189.10 (P1)
CLK_CRYSTAL: IC115.4 (O), IC412.14 (D1), SW1.2
CL_0: IC3.15 (D4)
CL_1: IC6.15 (D4)
CL_2: IC41.15 (D4)
CL_3: IC56.15 (D4)
CL_4: IC68.15 (D4)
CL_5: IC81.15 (D4)
CL_6: IC85.15 (D4)
CL_7: IC88.15 (D4)
CONDITION: IC175.5 (I1), IC341.4 (1Y)
COND_FLAG_SRC: IC15.1 (!A!/B)
COND_INVERT: IC175.4 (I0)
COND_SEL_0: IC12.11 (A), IC61.11 (A)
COND_SEL_1: IC12.10 (B), IC61.10 (B)
COND_SEL_2: IC12.9 (C), IC61.9 (C)
COND_SEL_3: IC341.1 (!A!/B)
DATA0: IC28.3 (1D)
DATA1: IC28.4 (2D)
DATA2: IC28.7 (3D)
DATA3: IC28.8 (4D)
DATA4: IC28.13 (5D)
DATA5: IC28.14 (6D)
DATA6: IC28.17 (7D)
DATA7: IC28.18 (8D)
DATA_BUS0: IC7.3 (1B), IC54.4 (1Y), IC187.13 (I/O1), IC188.11 (O0), IC208.2 (A1), IC208.18 (B1), IC219.18 (Y1)
DATA_BUS1: IC7.6 (2B), IC54.7 (2Y), IC187.14 (I/O2), IC188.12 (O1), IC208.3 (A2), IC208.17 (B2)
DATA_BUS2: IC7.10 (3B), IC54.9 (3Y), IC187.15 (I/O3), IC188.13 (O2), IC208.4 (A3), IC208.16 (B3)
DATA_BUS3: IC7.13 (4B), IC54.12 (4Y), IC187.17 (I/O4), IC188.15 (O3), IC208.5 (A4), IC208.15 (B4)
DATA_BUS4: IC24.3 (1B), IC96.4 (1Y), IC187.18 (I/O5), IC188.16 (O4), IC208.6 (A5), IC208.14 (B5)
DATA_BUS5: IC24.6 (2B), IC96.7 (2Y), IC187.19 (I/O6), IC188.17 (O5), IC208.7 (A6), IC208.13 (B6)
DATA_BUS6: IC24.10 (3B), IC96.9 (3Y), IC187.20 (I/O7), IC188.18 (O6), IC208.8 (A7), IC208.12 (B7)
DATA_BUS7: IC24.13 (4B), IC96.12 (4Y), IC187.21 (I/O8), IC188.19 (O7), IC208.9 (A8), IC208.11 (B8), IC218.12 (Y4)
DH_0: IC3.12 (D7)
DH_1: IC6.12 (D7)
DH_2: IC41.12 (D7)
DH_3: IC56.12 (D7)
DH_4: IC68.12 (D7)
DH_5: IC81.12 (D7)
DH_6: IC85.12 (D7)
DH_7: IC88.12 (D7)
DISPLAY_REG_LOAD: IC197.3 (I), IC202.13 (I2)
DI_H_0: IC2.12 (D7), IC109.2 (1Q)
DI_H_1: IC20.12 (D7), IC109.5 (2Q)
DI_H_2: IC44.12 (D7), IC109.6 (3Q)
DI_H_3: IC62.12 (D7), IC109.9 (4Q)
DI_H_4: IC69.12 (D7), IC109.12 (5Q)
DI_H_5: IC82.12 (D7), IC109.15 (6Q)
DI_H_6: IC86.12 (D7), IC109.16 (7Q)
DI_H_7: IC89.12 (D7), IC109.19 (8Q)
DI_L_0: IC2.13 (D6), IC110.2 (1Q)
DI_L_1: IC20.13 (D6), IC110.5 (2Q)
DI_L_2: IC44.13 (D6), IC110.6 (3Q)
DI_L_3: IC62.13 (D6), IC110.9 (4Q)
DI_L_4: IC69.13 (D6), IC110.12 (5Q)
DI_L_5: IC82.13 (D6), IC110.15 (6Q)
DI_L_6: IC86.13 (D6), IC110.16 (7Q)
DI_L_7: IC89.13 (D6), IC110.19 (8Q)
DL_0: IC3.13 (D6)
DL_1: IC6.13 (D6)
DL_2: IC41.13 (D6)
DL_3: IC56.13 (D6)
DL_4: IC68.13 (D6)
DL_5: IC81.13 (D6)
DL_6: IC85.13 (D6)
DL_7: IC88.13 (D6)
DMA_REQ: IC18.5 (I1), IC61.12 (D7), IC190.5 (Q)
D_WRT: IC210.1 (G)
EXT_INPUT: IC12.1 (D3), IC190.9 (Q)
FINAL_CONDITION: IC43.3 (I), IC175.6 (O)
FORCE_USER_PTB: IC18.9 (I0)
GND: IC12.7 (G), IC14.12 (D7), IC14.13 (D6), IC14.14 (D5), IC15.15 (G), IC16.4 (D0), IC16.7 (G), IC17.1 (G), IC17.19 (G), IC18.1 (I0), IC21.1 (A14), IC21.20 (!CE), IC21.26 (A13), IC23.12 (D7), IC23.13 (D6), IC23.14 (D5), IC25.11 (I2), IC34.5 (1C1), IC34.11 (2C1), IC35.5 (1C1), IC35.11 (2C1), IC36.5 (1C1), IC36.11 (2C1), IC39.2 (1A), IC39.5 (2A), IC39.11 (3A), IC39.15 (G), IC46.11 (B4), IC46.12 (A4), IC46.14 (A3), IC46.15 (B3), IC47.1 (1G), IC47.3 (1C3), IC47.10 (2C0), IC47.11 (2C1), IC47.12 (2C2), IC47.13 (2C3), IC47.15 (2G), IC49.5 (2A), IC49.11 (3A), IC49.14 (4A), IC49.15 (G), IC50.7 (C0), IC55.2 (1A), IC55.5 (2A), IC55.11 (3A), IC55.14 (4A), IC55.15 (G), IC61.7 (G), IC63.2 (1A), IC63.5 (2A), IC63.11 (3A), IC63.14 (4A), IC63.15 (G), IC100.2 (1A), IC100.5 (2A), IC100.10 (3B), IC100.11 (3A), IC100.13 (4B), IC100.14 (4A), IC100.15 (G), IC104.11 (3A), IC104.14 (4A), IC104.15 (G), IC105.5 (EI), IC112.5 (2A), IC112.11 (3A), IC112.14 (4A), IC112.15 (G), IC114.15 (G), IC120.1 (G), IC140.1 (A14), IC140.20 (!CE), IC140.26 (A13), IC142.2 (1A), IC142.5 (2A), IC142.11 (3A), IC142.14 (4A), IC147.2 (1A), IC147.5 (2A), IC147.11 (3A), IC147.14 (4A), IC149.4 (G2A), IC149.5 (G2B), IC163.1 (G), IC163.19 (G), IC186.11 (RES), IC187.2 (A16), IC187.31 (A15), IC188.1 (A15), IC189.11 (RES), IC202.2 (I1), IC206.15 (G), IC208.19 (G), IC214.3 (C), IC214.4 (G2A), IC214.5 (G2B), IC237.3 (1C3), IC255.4 (1C2), IC255.10 (2C0), IC255.11 (2C1), IC255.12 (2C2), IC255.13 (2C3), IC412.1 (M), IC412.2 (N), INT_CODE_REG1.3 (1D), INT_CODE_REG1.13 (5D), INT_CODE_REG1.14 (6D), INT_CODE_REG1.17 (7D), INT_CODE_REG1.18 (8D), S5.2, S7.2, S8.2, SW2.1, SW2.2, SW2.3, SW2.4, SW2.5, SW2.6, SW2.7, SW2.8, SW4.9, SW4.10, SW4.11, SW4.12, SW4.13, SW4.14, SW4.15, SW4.16, SW5.1, SW5.2, SW5.3, SW5.4, SW5.5, SW5.6, SW5.7, SW5.8
IDE: IC254.10 (Y5)
IMMY_0: IC98.2 (1A), IC256.3 (1B)
IMMY_1: IC98.5 (2A), IC256.6 (2B)
IMMY_2: IC98.11 (3A)
IMMY_3: IC98.14 (4A)
IMMY_4: IC122.2 (1A)
IMMY_5: IC122.5 (2A)
IMMY_6: IC122.11 (3A)
IMMY_7: IC122.14 (4A)
INT_0: R1.1, SW2.16
INT_1: R4.1, SW2.15
INT_2: R5.1, SW2.14
INT_3: R14.1, SW2.13
INT_4: R25.1, SW2.12
INT_5: R22.1, SW2.11
INT_6: R27.1, SW2.10
INT_7: R28.1, SW2.9
INT_MASKS_0: IC8.2 (1Q), IC42.1 (D3), IC139.1 (I0)
INT_MASKS_1: IC8.5 (2Q), IC80.1 (D3), IC139.4 (I0)
INT_MASKS_2: IC8.6 (3Q), IC130.1 (D3), IC139.9 (I0)
INT_MASKS_3: IC8.9 (4Q), IC133.1 (D3), IC139.12 (I0)
INT_MASKS_4: IC8.12 (5Q), IC141.1 (D3), IC148.1 (I0)
INT_MASKS_5: IC8.15 (6Q), IC144.1 (D3), IC148.4 (I0)
INT_MASKS_6: IC8.16 (7Q), IC148.9 (I0), IC152.1 (D3)
INT_MASKS_7: IC8.19 (8Q), IC148.12 (I0), IC160.1 (D3)
INT_MASKS_WRT: IC8.1 (G)
INT_PENDING: IC12.2 (D2), IC18.2 (I1), IC22.3 (O)
INT_REQUEST: IC22.1 (I0), IC105.15 (EO)
INT_REQ_0: IC74.3 (CLK)
INT_REQ_1: IC74.11 (CLK)
INT_REQ_2: IC107.3 (CLK)
INT_REQ_3: IC107.11 (CLK)
INT_REQ_4: IC108.3 (CLK)
INT_REQ_5: IC108.11 (CLK)
INT_REQ_6: IC137.3 (CLK)
INT_REQ_7: IC137.11 (CLK)
INT_STATUS_0: IC42.15 (D4), IC139.2 (I1), INT_STATUS_REG.2 (Q1)
INT_STATUS_1: IC80.15 (D4), IC139.5 (I1), INT_STATUS_REG.5 (Q2)
INT_STATUS_2: IC130.15 (D4), IC139.10 (I1), INT_STATUS_REG.6 (Q3)
INT_STATUS_3: IC133.15 (D4), IC139.13 (I1), INT_STATUS_REG.9 (Q4)
INT_STATUS_4: IC141.15 (D4), IC148.2 (I1), INT_STATUS_REG.12 (Q5)
INT_STATUS_5: IC144.15 (D4), IC148.5 (I1), INT_STATUS_REG.15 (Q6)
INT_STATUS_6: IC148.10 (I1), IC152.15 (D4), INT_STATUS_REG.16 (Q7)
INT_STATUS_7: IC148.13 (I1), IC160.15 (D4), INT_STATUS_REG.19 (Q8)
INT_VECTOR_0: IC42.2 (D2), INT_CODE_REG1.2 (1Q)
INT_VECTOR_1: IC80.2 (D2), IC149.1 (A), INT_CODE_REG1.5 (2Q)
INT_VECTOR_2: IC130.2 (D2), IC149.2 (B), INT_CODE_REG1.6 (3Q)
INT_VECTOR_3: IC133.2 (D2), IC149.3 (C), INT_CODE_REG1.9 (4Q)
INT_VECTOR_4: IC141.2 (D2), INT_CODE_REG1.12 (5Q)
INT_VECTOR_5: IC144.2 (D2), INT_CODE_REG1.15 (6Q)
INT_VECTOR_6: IC152.2 (D2), INT_CODE_REG1.16 (7Q)
INT_VECTOR_7: IC160.2 (D2), INT_CODE_REG1.19 (8Q)
INT_VECTOR_WRT: INT_CODE_REG1.1 (G)
IR_0: IC28.2 (1Q), IC37.5 (1C1)
IR_1: IC28.5 (2Q), IC37.11 (2C1)
IR_2: IC28.6 (3Q), IC38.5 (1C1)
IR_3: IC28.9 (4Q), IC38.11 (2C1)
IR_4: IC28.12 (5Q), IC40.5 (1C1)
IR_5: IC28.15 (6Q), IC40.11 (2C1)
IR_6: IC28.16 (7Q), IC73.5 (1C1)
IR_7: IC28.19 (8Q), IC73.11 (2C1)
IR_WRT: IC28.1 (G)
KBUS0: IC92.7 (1Y), IC98.3 (1B)
KBUS1: IC92.9 (2Y), IC98.6 (2B)
KBUS2: IC98.10 (3B), IC103.7 (1Y)
KBUS3: IC98.13 (4B), IC103.9 (2Y)
KBUS4: IC116.7 (1Y), IC122.3 (1B)
KBUS5: IC116.9 (2Y), IC122.6 (2B)
KBUS6: IC122.10 (3B), IC124.7 (1Y)
KBUS7: IC122.13 (4B), IC124.9 (2Y)
KSP_H_0: IC177.2 (1Q)
KSP_H_1: IC80.3 (D1), IC177.5 (2Q)
KSP_H_2: IC130.3 (D1), IC177.6 (3Q)
KSP_H_3: IC133.3 (D1), IC177.9 (4Q)
KSP_H_4: IC141.3 (D1), IC177.12 (5Q)
KSP_H_5: IC144.3 (D1), IC177.15 (6Q)
KSP_H_6: IC152.3 (D1), IC177.16 (7Q)
KSP_H_7: IC160.3 (D1), IC177.19 (8Q)
KSP_L_0: IC178.2 (1Q)
KSP_L_1: IC80.4 (D0), IC178.5 (2Q)
KSP_L_2: IC130.4 (D0), IC178.6 (3Q)
KSP_L_3: IC133.4 (D0), IC178.9 (4Q)
KSP_L_4: IC141.4 (D0), IC178.12 (5Q)
KSP_L_5: IC144.4 (D0), IC178.15 (6Q)
KSP_L_6: IC152.4 (D0), IC178.16 (7Q)
KSP_L_7: IC160.4 (D0), IC178.19 (8Q)
MARH_WRT: IC57.1 (G)
MARL_WRT: IC48.1 (G)
MAR_H_0: IC9.1 (D3), IC26.2 (A1), IC57.2 (1Q)
MAR_H_1: IC5.1 (D3), IC26.4 (A2), IC57.5 (2Q)
MAR_H_2: IC26.6 (A3), IC30.1 (D3), IC57.6 (3Q)
MAR_H_3: IC21.10 (A0), IC53.1 (D3), IC57.9 (4Q), IC114.2 (1A), IC140.10 (A0)
MAR_H_4: IC21.9 (A1), IC57.12 (5Q), IC67.1 (D3), IC114.5 (2A), IC140.9 (A1)
MAR_H_5: IC21.8 (A2), IC57.15 (6Q), IC71.1 (D3), IC114.11 (3A), IC140.8 (A2)
MAR_H_6: IC21.7 (A3), IC57.16 (7Q), IC84.1 (D3), IC114.14 (4A), IC140.7 (A3)
MAR_H_7: IC21.6 (A4), IC57.19 (8Q), IC87.1 (D3), IC112.2 (1A), IC140.6 (A4)
MAR_IN_SRC: IC128.1 (!A!/B), IC129.1 (!A!/B), IC131.1 (!A!/B), IC132.1 (!A!/B)
MAR_L_0: IC4.2 (A1), IC9.2 (D2), IC48.2 (1Q)
MAR_L_1: IC4.4 (A2), IC5.2 (D2), IC48.5 (2Q)
MAR_L_2: IC4.6 (A3), IC30.2 (D2), IC48.6 (3Q)
MAR_L_3: IC4.8 (A4), IC48.9 (4Q), IC53.2 (D2)
MAR_L_4: IC4.11 (A1), IC48.12 (5Q), IC67.2 (D2)
MAR_L_5: IC4.13 (A2), IC48.15 (6Q), IC71.2 (D2)
MAR_L_6: IC4.15 (A3), IC48.16 (7Q), IC84.2 (D2)
MAR_L_7: IC4.17 (A4), IC48.19 (8Q), IC87.2 (D2)
MDR_0_1: IC5.15 (D4), IC19.5 (2Q), IC54.5 (2A), IC92.10 (2C0), IC97.4 (A2)
MDR_0_2: IC19.6 (3Q), IC30.15 (D4), IC54.11 (3A), IC97.6 (A3), IC103.6 (1C0)
MDR_0_3: IC19.9 (4Q), IC53.15 (D4), IC54.14 (4A), IC97.8 (A4), IC103.10 (2C0)
MDR_0_4: IC19.12 (5Q), IC67.15 (D4), IC96.2 (1A), IC97.11 (A1), IC116.6 (1C0)
MDR_0_5: IC19.15 (6Q), IC71.15 (D4), IC96.5 (2A), IC97.13 (A2), IC116.10 (2C0)
MDR_0_6: IC19.16 (7Q), IC84.15 (D4), IC96.11 (3A), IC97.15 (A3), IC124.6 (1C0)
MDR_0_7: IC19.19 (8Q), IC87.15 (D4), IC96.14 (4A), IC97.17 (A4), IC124.10 (2C0)
MDR_0_WRT: IC19.1 (G)
MDR_1_1: IC5.14 (D5), IC54.6 (2B), IC92.11 (2C1), IC183.5 (2Q), IC185.4 (A2)
MDR_1_2: IC30.14 (D5), IC54.10 (3B), IC103.5 (1C1), IC183.6 (3Q), IC185.6 (A3)
MDR_1_3: IC53.14 (D5), IC54.13 (4B), IC103.11 (2C1), IC183.9 (4Q), IC185.8 (A4)
MDR_1_4: IC67.14 (D5), IC96.3 (1B), IC116.5 (1C1), IC183.12 (5Q), IC185.11 (A1)
MDR_1_5: IC71.14 (D5), IC96.6 (2B), IC116.11 (2C1), IC183.15 (6Q), IC185.13 (A2)
MDR_1_6: IC84.14 (D5), IC96.10 (3B), IC124.5 (1C1), IC183.16 (7Q), IC185.15 (A3)
MDR_1_7: IC87.14 (D5), IC96.13 (4B), IC124.11 (2C1), IC183.19 (8Q), IC185.17 (A4)
MDR_1_WRT: IC183.1 (G)
MDR_DATA_OUT: IC43.5 (I)
MDR_DATA_OUT_SRC: IC54.1 (!A!/B), IC96.1 (!A!/B)
MDR_H_0: IC9.14 (D5), IC54.3 (1B), IC92.5 (1C1), IC183.2 (1Q), IC185.2 (A1)
MDR_IN_BUS8: IC7.4 (1Y), IC19.3 (1D), IC183.3 (1D)
MDR_IN_BUS9: IC7.7 (2Y), IC19.4 (2D), IC183.4 (2D)
MDR_IN_BUS10: IC7.9 (3Y), IC19.7 (3D), IC183.7 (3D)
MDR_IN_BUS11: IC7.12 (4Y), IC19.8 (4D), IC183.8 (4D)
MDR_IN_BUS12: IC19.13 (5D), IC24.4 (1Y), IC183.13 (5D)
MDR_IN_BUS13: IC19.14 (6D), IC24.7 (2Y), IC183.14 (6D)
MDR_IN_BUS14: IC19.17 (7D), IC24.9 (3Y), IC183.17 (7D)
MDR_IN_BUS15: IC19.18 (8D), IC24.12 (4Y), IC183.18 (8D)
MDR_IN_SRC: IC7.1 (!A!/B), IC24.1 (!A!/B)
MDR_L_0: IC9.15 (D4), IC19.2 (1Q), IC54.2 (1A), IC92.6 (1C0), IC97.2 (A1)
MDR_TO_PAGETABLE_DATA_BUFFER: IC21.22 (!OE), IC115.9 (I), IC140.22 (!OE)
MEM_SELECT_0: IC164.15 (Y0), U1.22 (CE)
MEM_SELECT_1: IC164.14 (Y1), U2.22 (CE), U3.22 (CE), U4.22 (CE), U5.22 (CE), U6.22 (CE), U7.22 (CE), U8.22 (CE)
MEM_SELECT_2: IC164.13 (Y2)
MEM_SELECT_3: IC164.12 (Y3)
MEM_SELECT_4: IC164.11 (Y4)
MEM_SELECT_5: IC164.10 (Y5)
MEM_SELECT_6: IC164.9 (Y6)
MEM_SELECT_7: IC164.7 (Y7)
MSW_12: FLAGS.12 (Q5), IC181.6 (1C0), IC206.2 (1A)
MSW_13: FLAGS.15 (Q6), IC181.10 (2C0), IC206.5 (2A)
MSW_14: FLAGS.16 (Q7), IC99.16 (7Q), IC206.11 (3A)
MSW_15: FLAGS.19 (Q8), IC206.14 (4A)
MSW_CF: FLAGS.5 (Q2), IC14.4 (D0), IC15.5 (2A), IC16.2 (D2), IC47.5 (1C1)
MSW_CPU_MODE: IC12.4 (D0), IC18.10 (I1), IC99.6 (3Q), IC263.1 (I0), IC263.4 (I0)
MSW_DIR: IC12.15 (D4), IC99.19 (8Q)
MSW_DISPLAY_REG_LOAD: IC12.14 (D5), IC99.15 (6Q)
MSW_DMA_ACK: IC99.2 (1Q), IC151.4 (I0), IC174.4 (I0)
MSW_HALT: IC99.12 (5Q), IC151.5 (I1), IC174.5 (I1)
MSW_H_WRT: IC206.1 (!A!/B)
MSW_INTERRUPT_ENABLE: IC22.2 (I1), IC99.5 (2Q)
MSW_L_WRT: IC99.1 (G)
MSW_OF: FLAGS.9 (Q4), IC15.14 (4A), IC23.4 (D0)
MSW_PAGING_EN: IC39.1 (!A!/B), IC99.9 (4Q), IC104.1 (!A!/B), IC112.1 (!A!/B), IC114.1 (!A!/B)
MSW_SF: FLAGS.6 (Q3), IC15.11 (3A), IC255.6 (1C0)
MSW_ZF: FLAGS.2 (Q1), IC15.2 (1A), IC58.5 (I2), IC241.6 (1C0)
MUX_A: IC45.3 (O)
MUX_B: IC93.3 (O)
unnamed: IC1.3 (1B), IC170.7 (1Y)
unnamed: IC29.6 (1C0), IC41.5 (Y)
unnamed: IC29.5 (1C1), IC44.5 (Y)
unnamed: IC45.2 (I1), IC94.6 (O)
unnamed: IC74.5 (Q), INT_STATUS_REG.3 (D1)
unnamed: IC143.2 (I1), IC149.15 (Y0)
unnamed: IC42.5 (Y), IC180.3 (1C3)
unnamed: IC10.7 (CN), IC_86_0.3 (O)
unnamed: IC115.1 (I), IC412.7 (CLK), SW3.9, SW3.10, SW3.11, SW3.12, SW3.13, SW3.14, SW3.15, SW3.16
unnamed: IC80.5 (Y), IC180.13 (2C3)
unnamed: IC46.7 (C0), IC52.9 (C4)
unnamed: IC49.4 (1Y), IC50.6 (B1)
unnamed: IC29.3 (1C3), IC130.5 (Y)
unnamed: IC49.7 (2Y), IC50.2 (B2)
unnamed: IC47.7 (1Y), IC_86_0.1 (I0)
unnamed: IC48.3 (1D), IC131.4 (1Y)
unnamed: IC48.4 (2D), IC131.7 (2Y)
unnamed: IC48.7 (3D), IC131.9 (3Y)
unnamed: IC25.12 (O), IC58.1 (I0)
unnamed: IC25.6 (O), IC58.2 (I1)
unnamed: IC16.5 (Y), IC91.4 (1C2), IC113.11 (2C1)
unnamed: IC29.13 (2C3), IC133.5 (Y)
unnamed: IC64.3 (1C3), IC141.5 (Y)
unnamed: IC29.4 (1C2), IC30.5 (Y)
unnamed: IC25.8 (O), IC58.13 (I2)
unnamed: IC90.15 (G), IC195.15 (G)
unnamed: IC90.3 (1B), IC163.18 (Y1)
unnamed: IC48.8 (4D), IC131.12 (4Y)
unnamed: IC42.11 (A), IC125.4 (1Y)
unnamed: IC42.10 (B), IC125.7 (2Y)
unnamed: IC48.13 (5D), IC128.4 (1Y)
unnamed: IC26.8 (A4), IC114.4 (1Y)
unnamed: IC64.13 (2C3), IC144.5 (Y)
unnamed: IC49.9 (3Y), IC50.15 (B3)
unnamed: IC49.12 (4Y), IC50.11 (B4)
unnamed: IC51.6 (B1), IC55.4 (1Y)
unnamed: IC51.2 (B2), IC55.7 (2Y)
unnamed: IC51.15 (B3), IC55.9 (3Y)
unnamed: IC51.11 (B4), IC55.12 (4Y)
unnamed: FLAGS.3 (D1), IC241.7 (1Y)
unnamed: IC10.16 (CN+4), IC11.7 (CN)
unnamed: IC17.2 (A1), IC91.7 (1Y)
unnamed: IC26.11 (A1), IC114.7 (2Y)
unnamed: IC26.13 (A2), IC114.9 (3Y)
unnamed: IC17.4 (A2), IC91.9 (2Y)
unnamed: IC17.6 (A3), IC95.7 (1Y)
unnamed: IC17.8 (A4), IC95.9 (2Y)
unnamed: IC29.10 (2C0), IC56.5 (Y)
unnamed: IC83.3 (1C3), IC152.5 (Y)
unnamed: IC17.11 (A1), IC111.7 (1Y)
unnamed: IC21.11 (I/O0), IC39.3 (1B), IC185.18 (Y1)
unnamed: IC21.12 (I/O1), IC39.6 (2B), IC185.16 (Y2)
unnamed: IC21.13 (I/O2), IC39.10 (3B), IC185.14 (Y3)
unnamed: IC21.15 (I/O3), IC39.13 (4B), IC185.12 (Y4)
unnamed: IC97.9 (Y1), IC112.3 (1B), IC140.16 (I/O4)
unnamed: IC97.7 (Y2), IC112.6 (2B), IC140.17 (I/O5)
unnamed: IC97.5 (Y3), IC112.10 (3B), IC140.18 (I/O6)
unnamed: IC97.3 (Y4), IC112.13 (4B), IC140.19 (I/O7)
unnamed: IC52.6 (B1), IC63.4 (1Y)
unnamed: IC74.1 (CLR), IC143.3 (O)
unnamed: IC23.15 (D4), IC_86_0.8 (O)
unnamed: IC_04_2.1 (I), IC_86_1.8 (O)
unnamed: IC_10_0.3 (I0), IC_86_1.3 (O)
unnamed: IC_86_1.6 (O), IC_86_1.10 (I1)
unnamed: IC52.2 (B2), IC63.7 (2Y)
unnamed: IC52.15 (B3), IC63.9 (3Y)
unnamed: IC29.11 (2C1), IC62.5 (Y)
unnamed: IC75.3 (D1), IC227.11 (O0)
unnamed: IC32.3 (D1), IC34.7 (1Y)
unnamed: IC46.6 (B1), IC100.4 (1Y)
unnamed: IC43.4 (O), IC145.13 (I2)
unnamed: IC6.5 (Y), IC180.10 (2C0)
unnamed: IC_10_0.12 (O), IC_86_1.9 (I0)
unnamed: IC17.13 (A2), IC111.9 (2Y)
unnamed: IC83.13 (2C3), IC160.5 (Y)
unnamed: IC_04_2.2 (O), IC_10_0.5 (I2)
unnamed: IC61.13 (D6), IC167.6 (O)
unnamed: IC_02_0.1 (O), IC_10_0.13 (I2)
unnamed: FLAGS.4 (D2), IC14.5 (Y)
unnamed: IC1.6 (2B), IC170.9 (2Y)
unnamed: FLAGS.7 (D3), IC255.7 (1Y)
unnamed: IC20.5 (Y), IC180.11 (2C1)
unnamed: FLAGS.8 (D4), IC23.5 (Y)
unnamed: IC61.14 (D5), IC153.6 (O)
unnamed: IC94.5 (I1), IC119.3 (O)
unnamed: IC26.15 (A3), IC114.12 (4Y)
unnamed: IC231.3 (D1), IC237.7 (1Y)
unnamed: IC46.2 (B2), IC100.7 (2Y)
unnamed: IC231.4 (D2), IC270.7 (1Y)
unnamed: IC236.3 (O), IC237.4 (1C2)
unnamed: IC127.4 (1Y), IC231.8 (D4)
unnamed: IC121.4 (1Y), IC231.7 (D3)
unnamed: IC115.2 (O), IC126.3 (CLK)
unnamed: IC_04_2.3 (I), IC_10_0.6 (O)
unnamed: IC1.10 (3B), IC179.7 (1Y)
unnamed: IC26.17 (A4), IC112.4 (1Y)
unnamed: IC150.2 (A1), IC155.8 (O)
unnamed: IC17.15 (A3), IC113.7 (1Y)
unnamed: IC65.2 (A1), IC112.7 (2Y)
unnamed: IC1.13 (4B), IC179.9 (2Y)
unnamed: IC13.3 (1B), IC181.7 (1Y)
unnamed: IC105.4 (7), IC139.3 (O)
unnamed: IC65.4 (A2), IC112.9 (3Y)
unnamed: IC150.4 (A2), IC156.8 (O)
unnamed: IC5.5 (Y), IC180.12 (2C2)
unnamed: IC48.14 (6D), IC128.7 (2Y)
unnamed: IC48.17 (7D), IC128.9 (3Y)
unnamed: IC48.18 (8D), IC128.12 (4Y)
unnamed: IC57.3 (1D), IC129.4 (1Y)
unnamed: IC29.12 (2C2), IC53.5 (Y)
unnamed: IC64.6 (1C0), IC68.5 (Y)
unnamed: IC64.5 (1C1), IC69.5 (Y)
unnamed: IC64.4 (1C2), IC67.5 (Y)
unnamed: IC64.10 (2C0), IC81.5 (Y)
unnamed: IC64.11 (2C1), IC82.5 (Y)
unnamed: IC64.12 (2C2), IC71.5 (Y)
unnamed: IC83.6 (1C0), IC85.5 (Y)
unnamed: IC83.5 (1C1), IC86.5 (Y)
unnamed: IC83.4 (1C2), IC84.5 (Y)
unnamed: IC83.10 (2C0), IC88.5 (Y)
unnamed: IC32.4 (D2), IC34.9 (2Y)
unnamed: IC173.6 (O), IC201.1 (I0)
unnamed: IC17.17 (A4), IC113.9 (2Y)
unnamed: IC83.11 (2C1), IC89.5 (Y)
unnamed: IC13.6 (2B), IC181.9 (2Y)
unnamed: IC65.6 (A3), IC112.12 (4Y)
unnamed: IC39.4 (1Y), IC65.8 (A4)
unnamed: IC13.10 (3B), IC182.7 (1Y)
unnamed: IC13.13 (4B), IC182.9 (2Y)
unnamed: IC173.12 (O), IC201.2 (I1)
unnamed: IC205.2 (O), IC_10_0.9 (I0)
unnamed: IC188.20 (!CE), IC_10_0.8 (O)
unnamed: IC118.1 (!A!/B), IC125.1 (!A!/B), IC202.12 (O)
unnamed: IC168.6 (O), IC187.22 (!CE1)
unnamed: IC52.11 (B4), IC63.12 (4Y)
unnamed: IC83.12 (2C2), IC87.5 (Y)
unnamed: IC168.2 (I1), IC201.3 (O), IC_10_0.10 (I1)
unnamed: IC201.5 (I1), IC205.4 (O)
unnamed: IC187.9 (A3), IC188.7 (A3), IC207.12 (Y4)
unnamed: IC187.10 (A2), IC188.8 (A2), IC207.14 (Y3)
unnamed: IC187.11 (A1), IC188.9 (A1), IC207.16 (Y2)
unnamed: IC190.12 (D), R3.1, SW5.11
unnamed: IC49.1 (!A!/B), IC55.1 (!A!/B), IC63.1 (!A!/B), IC100.1 (!A!/B), IC145.12 (O)
unnamed: IC187.12 (A0), IC188.10 (A0), IC207.18 (Y1)
unnamed: IC43.2 (O), IC145.2 (I1)
unnamed: IC39.7 (2Y), IC65.11 (A1)
unnamed: IC187.5 (A7), IC188.3 (A7), IC203.12 (I7), IC207.3 (Y4)
unnamed: IC187.6 (A6), IC188.4 (A6), IC207.5 (Y3), IC254.3 (C)
unnamed: IC187.7 (A5), IC188.5 (A5), IC207.7 (Y2), IC254.2 (B)
unnamed: IC187.8 (A4), IC188.6 (A4), IC207.9 (Y1), IC254.1 (A)
unnamed: IC187.4 (A12), IC188.2 (A12), IC203.3 (I2), IC209.9 (Y1)
unnamed: IC187.27 (A8), IC188.25 (A8), IC203.11 (I6), IC209.18 (Y1)
unnamed: IC170.4 (1C2), IC184.2 (1Q)
unnamed: IC43.6 (O), IC54.15 (G), IC96.15 (G)
unnamed: IC187.23 (A10), IC188.21 (A10), IC203.5 (I4), IC209.14 (Y3)
unnamed: IC187.25 (A11), IC188.23 (A11), IC203.4 (I3), IC209.12 (Y4)
unnamed: IC187.28 (A13), IC188.26 (A13), IC203.2 (I1), IC209.7 (Y2)
unnamed: IC187.3 (A14), IC188.27 (A14), IC203.1 (I0), IC209.5 (Y3)
unnamed: IC205.6 (O), IC254.4 (G2A), IC254.5 (G2B)
unnamed: IC173.13 (I2), IC211.18 (Y1)
unnamed: IC173.2 (I1), IC211.16 (Y2)
unnamed: IC173.1 (I0), IC211.14 (Y3)
unnamed: IC43.8 (O), IC93.2 (I1), IC119.1 (I0)
unnamed: IC90.6 (2B), IC163.16 (Y2)
unnamed: IC90.10 (3B), IC163.14 (Y3)
unnamed: IC33.14 (D6), IC73.9 (2Y)
unnamed: IC33.13 (D5), IC73.7 (1Y)
unnamed: IC39.9 (3Y), IC65.13 (A2)
unnamed: IC39.12 (4Y), IC65.15 (A3)
unnamed: IC57.4 (2D), IC129.7 (2Y)
unnamed: IC90.13 (4B), IC163.12 (Y4)
unnamed: IC163.9 (Y1), IC195.3 (1B)
unnamed: IC163.7 (Y2), IC195.6 (2B)
unnamed: IC97.18 (Y1), IC114.3 (1B), IC140.11 (I/O0)
unnamed: IC97.16 (Y2), IC114.6 (2B), IC140.12 (I/O1)
unnamed: IC97.14 (Y3), IC114.10 (3B), IC140.13 (I/O2)
unnamed: IC163.5 (Y3), IC195.10 (3B)
unnamed: IC97.12 (Y4), IC114.13 (4B), IC140.15 (I/O3)
unnamed: IC21.16 (I/O4), IC104.3 (1B), IC185.9 (Y1)
unnamed: IC21.17 (I/O5), IC104.6 (2B), IC185.7 (Y2)
unnamed: IC21.18 (I/O6), IC104.10 (3B), IC185.5 (Y3)
unnamed: IC21.19 (I/O7), IC104.13 (4B), IC185.3 (Y4)
unnamed: IC57.7 (3D), IC129.9 (3Y)
unnamed: IC21.27 (!WE), IC138.8 (O), IC140.27 (!WE)
unnamed: IC163.3 (Y4), IC195.13 (4B)
unnamed: IC90.2 (1A), IC198.2 (1Q)
unnamed: IC90.5 (2A), IC198.5 (2Q)
unnamed: IC90.11 (3A), IC198.6 (3Q)
unnamed: IC90.14 (4A), IC198.9 (4Q)
unnamed: IC97.1 (G), IC97.19 (G), IC115.8 (O), IC185.1 (G), IC185.19 (G)
unnamed: IC65.17 (A4), IC104.4 (1Y)
unnamed: IC72.2 (A1), IC104.7 (2Y)
unnamed: FLAGS.13 (D5), IC206.4 (1Y)
unnamed: FLAGS.14 (D6), IC206.7 (2Y)
unnamed: IC57.8 (4D), IC129.12 (4Y)
unnamed: IC57.13 (5D), IC132.4 (1Y)
unnamed: IC57.14 (6D), IC132.7 (2Y)
unnamed: IC57.17 (7D), IC132.9 (3Y)
unnamed: IC57.18 (8D), IC132.12 (4Y)
unnamed: IC195.2 (1A), IC198.12 (5Q)
unnamed: IC195.5 (2A), IC198.15 (6Q)
unnamed: IC18.3 (O), IC18.4 (I0)
unnamed: IC195.11 (3A), IC198.16 (7Q)
unnamed: IC195.14 (4A), IC198.19 (8Q)
unnamed: IC190.2 (D), R15.1, SW5.12
unnamed: IC192.2 (S1), IC192.3 (S2), R16.1, S5.1 (O)
unnamed: IC192.1 (R), R17.1, S5.3 (S)
unnamed: IC193.2 (S1), IC193.3 (S2), R18.1, S7.1 (O)
unnamed: R11.1, SW4.6
unnamed: IC58.6 (O), IC241.4 (1C2)
unnamed: R12.1, SW4.7
unnamed: IC66.2 (1Q), IC142.3 (1B)
unnamed: IC66.5 (2Q), IC142.6 (2B)
unnamed: IC66.6 (3Q), IC142.10 (3B)
unnamed: IC66.9 (4Q), IC142.13 (4B)
unnamed: IC334.3 (D1), IC335.11 (O0)
unnamed: IC66.12 (5Q), IC147.3 (1B)
unnamed: IC334.4 (D2), IC335.12 (O1)
unnamed: IC334.7 (D3), IC335.13 (O2)
unnamed: IC334.8 (D4), IC335.15 (O3)
unnamed: IC66.15 (6Q), IC147.6 (2B)
unnamed: R13.1, SW4.8
unnamed: IC193.1 (R), R19.1, S7.3 (S)
unnamed: IC194.3 (S2), R20.1, S8.1 (O)
unnamed: IC66.16 (7Q), IC147.10 (3B)
unnamed: IC334.13 (D5), IC335.16 (O4)
unnamed: IC334.14 (D6), IC335.17 (O5)
unnamed: IC334.17 (D7), IC335.18 (O6)
unnamed: IC66.19 (8Q), IC147.13 (4B)
unnamed: IC334.18 (D8), IC335.19 (O7)
unnamed: IC336.3 (D1), IC337.11 (O0)
unnamed: IC336.4 (D2), IC337.12 (O1)
unnamed: IC336.7 (D3), IC337.13 (O2)
unnamed: IC336.8 (D4), IC337.15 (O3)
unnamed: IC336.13 (D5), IC337.16 (O4)
unnamed: IC336.14 (D6), IC337.17 (O5)
unnamed: IC336.17 (D7), IC337.18 (O6)
unnamed: IC336.18 (D8), IC337.19 (O7)
unnamed: IC338.3 (D1), IC339.11 (O0)
unnamed: IC338.4 (D2), IC339.12 (O1)
unnamed: IC338.7 (D3), IC339.13 (O2)
unnamed: IC338.8 (D4), IC339.15 (O3)
unnamed: IC338.13 (D5), IC339.16 (O4)
unnamed: IC338.14 (D6), IC339.17 (O5)
unnamed: IC338.17 (D7), IC339.18 (O6)
unnamed: IC338.18 (D8), IC339.19 (O7)
unnamed: IC21.5 (A5), IC140.5 (A5), IC142.4 (1Y)
unnamed: IC61.5 (Y), IC341.2 (1A)
unnamed: IC12.5 (Y), IC341.3 (1B)
unnamed: IC21.4 (A6), IC140.4 (A6), IC142.7 (2Y)
unnamed: IC21.3 (A7), IC140.3 (A7), IC142.9 (3Y)
unnamed: IC21.25 (A8), IC140.25 (A8), IC142.12 (4Y)
unnamed: IC21.24 (A9), IC140.24 (A9), IC147.4 (1Y)
unnamed: IC21.21 (A10), IC140.21 (A10), IC147.7 (2Y)
unnamed: IC21.23 (A11), IC140.23 (A11), IC147.9 (3Y)
unnamed: IC21.2 (A12), IC140.2 (A12), IC147.12 (4Y)
unnamed: IC194.1 (R), R21.1, S8.3 (S)
unnamed: IC197.4 (O), IC198.1 (G)
unnamed: IC105.9 (A0), INT_CODE_REG1.4 (2D)
unnamed: IC32.7 (D3), IC35.7 (1Y)
unnamed: IC32.8 (D4), IC35.9 (2Y)
unnamed: IC32.13 (D5), IC36.7 (1Y)
unnamed: IC32.14 (D6), IC36.9 (2Y)
unnamed: IC32.17 (D7), IC37.7 (1Y)
unnamed: IC32.18 (D8), IC37.9 (2Y)
unnamed: IC33.3 (D1), IC38.7 (1Y)
unnamed: IC33.4 (D2), IC38.9 (2Y)
unnamed: IC33.7 (D3), IC40.7 (1Y)
unnamed: IC33.8 (D4), IC40.9 (2Y)
unnamed: IC168.5 (I3), IC201.4 (I0), IC205.1 (I), IC209.3 (Y4)
unnamed: IC187.26 (A9), IC188.24 (A9), IC203.6 (I5), IC209.16 (Y2)
unnamed: IC201.6 (O), IC254.6 (G1)
unnamed: IC170.12 (2C2), IC184.5 (2Q)
unnamed: IC179.4 (1C2), IC184.6 (3Q)
unnamed: IC179.12 (2C2), IC184.9 (4Q)
unnamed: IC181.4 (1C2), IC184.12 (5Q)
unnamed: IC181.12 (2C2), IC184.15 (6Q)
unnamed: IC182.4 (1C2), IC184.16 (7Q)
unnamed: IC182.12 (2C2), IC184.19 (8Q)
unnamed: IC170.3 (1C3), IC204.2 (1Q)
unnamed: IC170.13 (2C3), IC204.5 (2Q)
unnamed: IC179.3 (1C3), IC204.6 (3Q)
unnamed: IC179.13 (2C3), IC204.9 (4Q)
unnamed: IC181.3 (1C3), IC204.12 (5Q)
unnamed: IC181.13 (2C3), IC204.15 (6Q)
unnamed: IC182.3 (1C3), IC204.16 (7Q)
unnamed: IC182.13 (2C3), IC204.19 (8Q)
unnamed: IC221.6 (O), IC232.4 (I1)
unnamed: IC213.22 (!CE1), IC232.6 (O)
unnamed: IC214.12 (Y3), IC234.13 (I), IC252.2 (I0)
unnamed: IC214.13 (Y2), IC215.2 (I0), IC238.13 (I)
unnamed: IC232.3 (I0), IC244.3 (O)
unnamed: FLAGS.17 (D7), IC206.9 (3Y)
unnamed: FLAGS.18 (D8), IC206.12 (4Y)
unnamed: IC251.5 (I1), IC252.1 (O)
unnamed: IC239.12 (O), IC240.2 (I1)
unnamed: IC240.1 (I0), IC249.3 (I1), IC250.5 (Q2)
unnamed: IC238.12 (O), IC242.2 (I1)
unnamed: IC215.3 (I1), IC242.1 (I0), IC250.6 (Q3)
unnamed: IC234.12 (O), IC244.2 (I1)
unnamed: IC244.1 (I0), IC250.9 (Q4), IC252.3 (I1)
unnamed: IC221.5 (I1), IC240.3 (O)
unnamed: IC221.4 (I0), IC242.3 (O)
unnamed: IC212.20 (!CE), IC247.3 (O)
unnamed: IC246.12 (O), IC247.2 (I1)
unnamed: IC247.1 (I0), IC248.12 (O)
unnamed: IC202.6 (O), IC248.13 (I)
unnamed: IC199.20 (!CE), IC199.22 (!OE), IC227.20 (!CE), IC227.22 (!OE), IC243.20 (!CE), IC243.22 (!OE), IC257.20 (!CE), IC257.22 (!OE), IC261.20 (!CE), IC261.22 (!OE), IC262.20 (!CE), IC262.22 (!OE), IC302.20 (!CE), IC302.22 (!OE), IC303.20 (!CE), IC303.22 (!OE), IC333.20 (!CE), IC333.22 (!OE), IC335.20 (!CE), IC335.22 (!OE), IC337.20 (!CE), IC337.22 (!OE), IC339.20 (!CE), IC339.22 (!OE)
unnamed: IC202.5 (I2), IC249.1 (O)
unnamed: IC214.14 (Y1), IC239.13 (I), IC249.2 (I0)
unnamed: IC202.4 (I1), IC215.1 (O)
unnamed: IC105.11 (1), IC148.8 (O)
unnamed: IC202.3 (I0), IC251.6 (O)
unnamed: IC50.9 (C4), IC51.7 (C0)
unnamed: IC51.9 (C4), IC52.7 (C0)
unnamed: IC214.15 (Y0), IC253.13 (I)
unnamed: IC251.4 (I0), IC253.12 (O)
unnamed: IC231.13 (D5), IC256.4 (1Y)
unnamed: IC231.14 (D6), IC256.7 (2Y)
unnamed: IC164.1 (A), IC173.5 (I2), IC211.12 (Y4)
unnamed: IC164.2 (B), IC173.4 (I1), IC211.9 (Y1)
unnamed: IC105.3 (6), IC139.6 (O)
unnamed: IC164.3 (C), IC173.3 (I0), IC211.7 (Y2)
unnamed: IC75.4 (D2), IC227.12 (O1)
unnamed: IC75.7 (D3), IC227.13 (O2)
unnamed: IC107.13 (CLR), IC143.11 (O)
unnamed: IC108.1 (CLR), IC146.3 (O)
unnamed: IC75.8 (D4), IC227.15 (O3)
unnamed: IC75.13 (D5), IC227.16 (O4)
unnamed: IC75.14 (D6), IC227.17 (O5)
unnamed: IC60.3 (D1), IC333.11 (O0)
unnamed: IC60.4 (D2), IC333.12 (O1)
unnamed: IC60.7 (D3), IC333.13 (O2)
unnamed: IC60.8 (D4), IC333.15 (O3)
unnamed: IC60.13 (D5), IC333.16 (O4)
unnamed: IC60.14 (D6), IC333.17 (O5)
unnamed: IC60.17 (D7), IC333.18 (O6)
unnamed: IC60.18 (D8), IC333.19 (O7)
unnamed: IC108.13 (CLR), IC146.6 (O)
unnamed: IC146.12 (I0), IC149.7 (Y7)
unnamed: IC143.5 (I1), IC149.14 (Y1)
unnamed: IC143.10 (I1), IC149.13 (Y2)
unnamed: IC146.1 (I0), IC149.11 (Y4)
unnamed: IC146.9 (I0), IC149.9 (Y6)
unnamed: IC137.13 (CLR), IC146.11 (O)
unnamed: IC74.13 (CLR), IC143.6 (O)
unnamed: IC107.1 (CLR), IC143.8 (O)
unnamed: IC137.1 (CLR), IC146.8 (O)
unnamed: IC105.2 (5), IC139.8 (O)
unnamed: IC105.1 (4), IC139.11 (O)
unnamed: IC105.13 (3), IC148.3 (O)
unnamed: IC105.12 (2), IC148.6 (O)
unnamed: IC105.10 (0), IC148.11 (O)
unnamed: IC76.3 (D1), IC199.11 (O0)
unnamed: IC76.4 (D2), IC199.12 (O1)
unnamed: IC75.17 (D7), IC227.18 (O6)
unnamed: IC75.18 (D8), IC227.19 (O7)
unnamed: IC76.7 (D3), IC199.13 (O2)
unnamed: IC76.8 (D4), IC199.15 (O3)
unnamed: IC76.13 (D5), IC199.16 (O4)
unnamed: IC76.14 (D6), IC199.17 (O5)
unnamed: IC76.17 (D7), IC199.18 (O6)
unnamed: IC76.18 (D8), IC199.19 (O7)
unnamed: IC77.3 (D1), IC243.11 (O0)
unnamed: IC77.4 (D2), IC243.12 (O1)
unnamed: IC77.7 (D3), IC243.13 (O2)
unnamed: IC77.8 (D4), IC243.15 (O3)
unnamed: IC77.13 (D5), IC243.16 (O4)
unnamed: IC77.14 (D6), IC243.17 (O5)
unnamed: IC77.17 (D7), IC243.18 (O6)
unnamed: IC77.18 (D8), IC243.19 (O7)
unnamed: IC78.3 (D1), IC257.11 (O0)
unnamed: IC78.4 (D2), IC257.12 (O1)
unnamed: IC78.7 (D3), IC257.13 (O2)
unnamed: IC78.8 (D4), IC257.15 (O3)
unnamed: IC78.13 (D5), IC257.16 (O4)
unnamed: IC78.14 (D6), IC257.17 (O5)
unnamed: IC78.17 (D7), IC257.18 (O6)
unnamed: IC78.18 (D8), IC257.19 (O7)
unnamed: IC79.3 (D1), IC261.11 (O0)
unnamed: IC79.4 (D2), IC261.12 (O1)
unnamed: IC79.7 (D3), IC261.13 (O2)
unnamed: IC79.8 (D4), IC261.15 (O3)
unnamed: IC79.13 (D5), IC261.16 (O4)
unnamed: IC79.14 (D6), IC261.17 (O5)
unnamed: IC79.17 (D7), IC261.18 (O6)
unnamed: IC79.18 (D8), IC261.19 (O7)
unnamed: IC134.18 (D8), IC262.19 (O7)
unnamed: IC134.17 (D7), IC262.18 (O6)
unnamed: IC134.14 (D6), IC262.17 (O5)
unnamed: IC134.13 (D5), IC262.16 (O4)
unnamed: IC134.8 (D4), IC262.15 (O3)
unnamed: IC134.7 (D3), IC262.13 (O2)
unnamed: IC134.4 (D2), IC262.12 (O1)
unnamed: IC134.3 (D1), IC262.11 (O0)
unnamed: IC135.3 (D1), IC302.11 (O0)
unnamed: IC135.4 (D2), IC302.12 (O1)
unnamed: IC135.7 (D3), IC302.13 (O2)
unnamed: IC135.8 (D4), IC302.15 (O3)
unnamed: IC135.13 (D5), IC302.16 (O4)
unnamed: IC135.14 (D6), IC302.17 (O5)
unnamed: IC135.17 (D7), IC302.18 (O6)
unnamed: IC135.18 (D8), IC302.19 (O7)
unnamed: IC136.3 (D1), IC303.11 (O0)
unnamed: IC136.4 (D2), IC303.12 (O1)
unnamed: IC136.7 (D3), IC303.13 (O2)
unnamed: IC136.8 (D4), IC303.15 (O3)
unnamed: IC136.13 (D5), IC303.16 (O4)
unnamed: IC136.14 (D6), IC303.17 (O5)
unnamed: IC136.17 (D7), IC303.18 (O6)
unnamed: IC136.18 (D8), IC303.19 (O7)
unnamed: IC3.5 (Y), IC180.6 (1C0)
unnamed: IC2.5 (Y), IC180.5 (1C1)
unnamed: IC9.5 (Y), IC180.4 (1C2)
unnamed: IC143.12 (I0), IC149.12 (Y3)
unnamed: IC146.4 (I0), IC149.10 (Y5)
unnamed: IC115.3 (I), IC412.3 (Q1)
unnamed: IC105.7 (A1), INT_CODE_REG1.7 (3D)
unnamed: IC105.6 (A2), INT_CODE_REG1.8 (4D)
NET563434: IC120.2 (A1), SW1.9, SW1.10, SW1.11, SW1.12, SW1.13, SW1.14, SW1.15, SW1.16
OF_IN_SRC_0: IC23.11 (A)
OF_IN_SRC_1: IC23.10 (B)
OF_IN_SRC_2: IC23.9 (C)
PAGE_PRESENT: IC65.3 (Y4)
PAGE_TABLE_ADDR_SOURCE: IC18.8 (O), IC142.1 (!A!/B), IC147.1 (!A!/B)
PAGE_TABLE_WE: IC138.9 (I)
PAGE_WRITEABLE: IC72.18 (Y1)
PANEL_ADDRESS_0: IC223.2 (A1)
PANEL_ADDRESS_1: IC223.4 (A2)
PANEL_ADDRESS_2: IC223.6 (A3)
PANEL_ADDRESS_3: IC223.8 (A4)
PANEL_ADDRESS_4: IC222.2 (A1)
PANEL_ADDRESS_5: IC222.4 (A2)
PANEL_ADDRESS_6: IC222.6 (A3)
PANEL_ADDRESS_7: IC222.8 (A4)
PANEL_ADDRESS_8: IC224.2 (A1)
PANEL_ADDRESS_9: IC224.4 (A2)
PANEL_ADDRESS_10: IC224.6 (A3)
PANEL_ADDRESS_11: IC224.8 (A4)
PANEL_ADDRESS_12: IC225.2 (A1)
PANEL_ADDRESS_13: IC225.4 (A2)
PANEL_ADDRESS_14: IC225.6 (A3)
PANEL_ADDRESS_15: IC225.8 (A4)
PANEL_ADDRESS_16: IC228.2 (A1)
PANEL_ADDRESS_17: IC228.4 (A2)
PANEL_ADDRESS_18: IC228.6 (A3)
PANEL_ADDRESS_19: IC228.8 (A4)
PANEL_ADDRESS_20: IC229.2 (A1)
PANEL_ADDRESS_21: IC229.4 (A2)
PANEL_DATA_0: IC219.2 (A1)
PANEL_DATA_1: IC219.4 (A2)
PANEL_DATA_2: IC219.6 (A3)
PANEL_DATA_3: IC219.8 (A4)
PANEL_DATA_4: IC218.2 (A1)
PANEL_DATA_5: IC218.4 (A2)
PANEL_DATA_6: IC218.6 (A3)
PANEL_DATA_7: IC218.8 (A4)
PANEL_MEM_IO: IC27.6 (A3), IC194.4 (Q)
PANEL_RD: IC27.2 (A1), IC192.4 (Q)
PANEL_REGSEL_0: IC125.2 (1A), R6.1, SW4.1
PANEL_REGSEL_1: IC125.5 (2A), R7.1, SW4.2
PANEL_REGSEL_2: IC125.11 (3A), R8.1, SW4.3
PANEL_REGSEL_3: IC125.14 (4A), R9.1, SW4.4
PANEL_REGSEL_4: IC118.2 (1A), R10.1, SW4.5
PANEL_WR: IC27.4 (A2), IC193.4 (Q)
PC_H_0: IC9.3 (D1), IC129.3 (1B)
PC_H_1: IC5.3 (D1), IC129.6 (2B)
PC_H_2: IC30.3 (D1), IC129.10 (3B)
PC_H_3: IC53.3 (D1), IC129.13 (4B)
PC_H_4: IC67.3 (D1), IC132.3 (1B)
PC_H_5: IC71.3 (D1), IC132.6 (2B)
PC_H_6: IC84.3 (D1), IC132.10 (3B)
PC_H_7: IC87.3 (D1), IC132.13 (4B)
PC_H_15: IC101.19 (8Q)
PC_H_WRT: IC101.1 (G)
PC_L_0: IC9.4 (D0), IC102.2 (1Q), IC131.3 (1B)
PC_L_1: IC5.4 (D0), IC102.5 (2Q), IC131.6 (2B)
PC_L_2: IC30.4 (D0), IC102.6 (3Q), IC131.10 (3B)
PC_L_3: IC53.4 (D0), IC131.13 (4B)
PC_L_4: IC67.4 (D0), IC128.3 (1B)
PC_L_5: IC71.4 (D0), IC128.6 (2B)
PC_L_6: IC84.4 (D0), IC128.10 (3B)
PC_L_7: IC87.4 (D0), IC128.13 (4B)
PC_L_WRT: IC102.1 (G)
PIO_0: IC254.12 (Y3)
PIO_1: IC254.11 (Y4)
PTB_WRT: IC66.1 (G)
RD: IC155.9 (I)
RESET: IC411.1 (R), R24.1, SW5.13
RST: IC115.5 (I), IC412.15 (CLR), R2.1, SW5.16
RTC: IC254.13 (Y2)
SET: IC411.2 (S1), IC411.3 (S2), R23.1, SW5.14
SF_IN_SRC_0: IC255.14 (A)
SF_IN_SRC_1: IC255.2 (B)
SF_XOR_OF1: IC59.6 (O), IC61.15 (D4), IC153.4 (I0)
SHIFT_SRC_0: IC16.11 (A)
SHIFT_SRC_1: IC16.10 (B)
SHIFT_SRC_2: IC16.9 (C)
SINGLE_STEP_CLK: IC411.4 (Q), SW1.1
SI_H_0: IC2.14 (D5), IC31.2 (1Q)
SI_H_1: IC20.14 (D5), IC31.5 (2Q)
SI_H_2: IC31.6 (3Q), IC44.14 (D5)
SI_H_3: IC31.9 (4Q), IC62.14 (D5)
SI_H_4: IC31.12 (5Q), IC69.14 (D5)
SI_H_5: IC31.15 (6Q), IC82.14 (D5)
SI_H_6: IC31.16 (7Q), IC86.14 (D5)
SI_H_7: IC31.19 (8Q), IC89.14 (D5)
SI_L_0: IC2.15 (D4), IC106.2 (1Q)
SI_L_1: IC20.15 (D4), IC106.5 (2Q)
SI_L_2: IC44.15 (D4), IC106.6 (3Q)
SI_L_3: IC62.15 (D4), IC106.9 (4Q)
SI_L_4: IC69.15 (D4), IC106.12 (5Q)
SI_L_5: IC82.15 (D4), IC106.15 (6Q)
SI_L_6: IC86.15 (D4), IC106.16 (7Q)
SI_L_7: IC89.15 (D4), IC106.19 (8Q)
SPH_WRT: IC245.1 (G), IC263.5 (I1)
SPL_WRT: IC260.1 (G), IC263.2 (I1)
SP_H_0: IC2.3 (D1), IC245.2 (1Q)
SP_H_1: IC20.3 (D1), IC245.5 (2Q)
SP_H_2: IC44.3 (D1), IC245.6 (3Q)
SP_H_3: IC62.3 (D1), IC245.9 (4Q)
SP_H_4: IC69.3 (D1), IC245.12 (5Q)
SP_H_5: IC82.3 (D1), IC245.15 (6Q)
SP_H_6: IC86.3 (D1), IC245.16 (7Q)
SP_H_7: IC89.3 (D1), IC245.19 (8Q)
SP_L_0: IC2.4 (D0), IC260.2 (1Q)
SP_L_1: IC20.4 (D0), IC260.5 (2Q)
SP_L_2: IC44.4 (D0), IC260.6 (3Q)
SP_L_3: IC62.4 (D0), IC260.9 (4Q)
SP_L_4: IC69.4 (D0), IC260.12 (5Q)
SP_L_5: IC82.4 (D0), IC260.15 (6Q)
SP_L_6: IC86.4 (D0), IC260.16 (7Q)
SP_L_7: IC89.4 (D0), IC260.19 (8Q)
SSP_H_0: IC42.3 (D1)
SSP_H_WRT: IC177.1 (G), IC263.6 (O)
SSP_L_0: IC42.4 (D0)
SSP_L_WRT: IC178.1 (G), IC263.3 (O)
STOP_CLK_REQ: IC126.2 (D), R26.1, SW5.15
STOP_CLOCK: IC126.5 (Q), IC412.9 (G1), IC412.10 (G2)
TDR_H_0: IC9.12 (D7), IC92.3 (1C3)
TDR_H_1: IC5.12 (D7), IC92.13 (2C3)
TDR_H_2: IC30.12 (D7), IC103.3 (1C3)
TDR_H_3: IC53.12 (D7), IC103.13 (2C3)
TDR_H_4: IC67.12 (D7), IC116.3 (1C3)
TDR_H_5: IC71.12 (D7), IC116.13 (2C3)
TDR_H_6: IC84.12 (D7), IC124.3 (1C3)
TDR_H_7: IC87.12 (D7), IC124.13 (2C3)
TDR_H_WRT: IC158.1 (G)
TDR_L_0: IC9.13 (D6), IC92.4 (1C2)
TDR_L_1: IC5.13 (D6), IC92.12 (2C2)
TDR_L_2: IC30.13 (D6), IC103.4 (1C2)
TDR_L_3: IC53.13 (D6), IC103.12 (2C2)
TDR_L_4: IC67.13 (D6), IC116.4 (1C2)
TDR_L_5: IC71.13 (D6), IC116.12 (2C2)
TDR_L_6: IC84.13 (D6), IC124.4 (1C2)
TDR_L_7: IC87.13 (D6), IC124.12 (2C2)
TDR_L_WRT: IC157.1 (G)
TIMER: IC254.9 (Y6)
TYP0: IC43.9 (I), IC94.4 (I0)
TYP1: IC45.1 (I0), IC93.1 (I0)
TYP_0: IC145.1 (I0)
TYP_1: IC43.1 (I)
UART_0: IC254.15 (Y0)
UART_1: IC254.14 (Y1)
U_AD0: IC32.2 (Q1), IC227.10 (A0)
U_AD1: IC32.5 (Q2), IC227.9 (A1)
U_AD2: IC32.6 (Q3), IC227.8 (A2)
U_AD3: IC32.9 (Q4), IC227.7 (A3)
U_AD4: IC32.12 (Q5), IC227.6 (A4)
U_AD5: IC32.15 (Q6), IC227.5 (A5)
U_AD6: IC32.16 (Q7), IC227.4 (A6)
U_AD7: IC32.19 (Q8), IC227.3 (A7)
U_AD8: IC33.2 (Q1), IC227.25 (A8)
U_AD9: IC33.5 (Q2), IC227.24 (A9)
U_AD10: IC33.6 (Q3), IC227.21 (A10)
U_AD11: IC33.9 (Q4), IC227.23 (A11)
U_AD12: IC33.12 (Q5), IC46.5 (A1), IC199.2 (A12), IC227.2 (A12), IC243.2 (A12), IC257.2 (A12), IC261.2 (A12), IC262.2 (A12), IC302.2 (A12), IC303.2 (A12), IC333.2 (A12), IC335.2 (A12), IC337.2 (A12), IC339.2 (A12)
U_AD13: IC33.15 (Q6), IC46.3 (A2), IC199.26 (A13), IC227.26 (A13), IC243.26 (A13), IC257.26 (A13), IC261.26 (A13), IC262.26 (A13), IC302.26 (A13), IC303.26 (A13), IC333.26 (A13), IC335.26 (A13), IC337.26 (A13), IC339.26 (A13)
U_AD16: IC333.10 (A0)
U_AD17: IC333.9 (A1)
U_AD18: IC333.8 (A2)
U_AD19: IC333.7 (A3)
U_AD20: IC333.6 (A4)
U_AD21: IC333.5 (A5)
U_AD22: IC333.4 (A6)
U_AD23: IC333.3 (A7)
U_AD24: IC333.25 (A8)
U_AD25: IC333.24 (A9)
U_AD26: IC333.21 (A10)
U_AD27: IC333.23 (A11)
U_AD32: IC199.10 (A0)
U_AD33: IC199.9 (A1)
U_AD34: IC199.8 (A2)
U_AD35: IC199.7 (A3)
U_AD36: IC199.6 (A4)
U_AD37: IC199.5 (A5)
U_AD38: IC199.4 (A6)
U_AD39: IC199.3 (A7)
U_AD40: IC199.25 (A8)
U_AD41: IC199.24 (A9)
U_AD42: IC199.21 (A10)
U_AD43: IC199.23 (A11)
U_AD48: IC243.10 (A0)
U_AD49: IC243.9 (A1)
U_AD50: IC243.8 (A2)
U_AD51: IC243.7 (A3)
U_AD52: IC243.6 (A4)
U_AD53: IC243.5 (A5)
U_AD54: IC243.4 (A6)
U_AD55: IC243.3 (A7)
U_AD56: IC243.25 (A8)
U_AD57: IC243.24 (A9)
U_AD58: IC243.21 (A10)
U_AD59: IC243.23 (A11)
U_AD64: IC257.10 (A0)
U_AD65: IC257.9 (A1)
U_AD66: IC257.8 (A2)
U_AD67: IC257.7 (A3)
U_AD68: IC257.6 (A4)
U_AD69: IC257.5 (A5)
U_AD70: IC257.4 (A6)
U_AD71: IC257.3 (A7)
U_AD72: IC257.25 (A8)
U_AD73: IC257.24 (A9)
U_AD74: IC257.21 (A10)
U_AD75: IC257.23 (A11)
U_AD80: IC261.10 (A0)
U_AD81: IC261.9 (A1)
U_AD82: IC261.8 (A2)
U_AD83: IC261.7 (A3)
U_AD84: IC261.6 (A4)
U_AD85: IC261.5 (A5)
U_AD86: IC261.4 (A6)
U_AD87: IC261.3 (A7)
U_AD88: IC261.25 (A8)
U_AD89: IC261.24 (A9)
U_AD90: IC261.21 (A10)
U_AD91: IC261.23 (A11)
U_AD96: IC262.10 (A0)
U_AD97: IC262.9 (A1)
U_AD98: IC262.8 (A2)
U_AD99: IC262.7 (A3)
U_AD100: IC262.6 (A4)
U_AD101: IC262.5 (A5)
U_AD102: IC262.4 (A6)
U_AD103: IC262.3 (A7)
U_AD104: IC262.25 (A8)
U_AD105: IC262.24 (A9)
U_AD106: IC262.21 (A10)
U_AD107: IC262.23 (A11)
U_AD112: IC302.10 (A0)
U_AD113: IC302.9 (A1)
U_AD114: IC302.8 (A2)
U_AD115: IC302.7 (A3)
U_AD116: IC302.6 (A4)
U_AD117: IC302.5 (A5)
U_AD118: IC302.4 (A6)
U_AD119: IC302.3 (A7)
U_AD120: IC302.25 (A8)
U_AD121: IC302.24 (A9)
U_AD122: IC302.21 (A10)
U_AD123: IC302.23 (A11)
U_AD128: IC303.10 (A0)
U_AD129: IC303.9 (A1)
U_AD130: IC303.8 (A2)
U_AD131: IC303.7 (A3)
U_AD132: IC303.6 (A4)
U_AD133: IC303.5 (A5)
U_AD134: IC303.4 (A6)
U_AD135: IC303.3 (A7)
U_AD136: IC303.25 (A8)
U_AD137: IC303.24 (A9)
U_AD138: IC303.21 (A10)
U_AD139: IC303.23 (A11)
U_AD224: IC335.10 (A0)
U_AD225: IC335.9 (A1)
U_AD226: IC335.8 (A2)
U_AD227: IC335.7 (A3)
U_AD228: IC335.6 (A4)
U_AD229: IC335.5 (A5)
U_AD230: IC335.4 (A6)
U_AD231: IC335.3 (A7)
U_AD232: IC335.25 (A8)
U_AD233: IC335.24 (A9)
U_AD234: IC335.21 (A10)
U_AD235: IC335.23 (A11)
U_AD240: IC337.10 (A0)
U_AD241: IC337.9 (A1)
U_AD242: IC337.8 (A2)
U_AD243: IC337.7 (A3)
U_AD244: IC337.6 (A4)
U_AD245: IC337.5 (A5)
U_AD246: IC337.4 (A6)
U_AD247: IC337.3 (A7)
U_AD248: IC337.25 (A8)
U_AD249: IC337.24 (A9)
U_AD250: IC337.21 (A10)
U_AD251: IC337.23 (A11)
U_AD256: IC339.10 (A0)
U_AD257: IC339.9 (A1)
U_AD258: IC339.8 (A2)
U_AD259: IC339.7 (A3)
U_AD260: IC339.6 (A4)
U_AD261: IC339.5 (A5)
U_AD262: IC339.4 (A6)
U_AD263: IC339.3 (A7)
U_AD264: IC339.25 (A8)
U_AD265: IC339.24 (A9)
U_AD266: IC339.21 (A10)
U_AD267: IC339.23 (A11)
U_ADDER_0: IC34.6 (1C0), IC50.4 (S1)
U_ADDER_1: IC34.10 (2C0), IC50.1 (S2)
U_ADDER_2: IC35.6 (1C0), IC50.13 (S3)
U_ADDER_3: IC35.10 (2C0), IC50.10 (S4)
U_ADDER_4: IC36.6 (1C0), IC51.4 (S1)
U_ADDER_5: IC36.10 (2C0), IC51.1 (S2)
U_ADDER_6: IC37.6 (1C0), IC51.13 (S3)
U_ADDER_7: IC37.10 (2C0), IC51.10 (S4)
U_ADDER_8: IC38.6 (1C0), IC52.4 (S1)
U_ADDER_9: IC38.10 (2C0), IC52.1 (S2)
U_ADDER_10: IC40.6 (1C0), IC52.13 (S3)
U_ADDER_11: IC40.10 (2C0), IC52.10 (S4)
U_ADDER_12: IC46.4 (S1), IC73.6 (1C0)
U_ADDER_13: IC46.1 (S2), IC73.10 (2C0)
U_CF: IC15.6 (2B), IC16.3 (D1), IC47.4 (1C2), IC231.5 (Q2), IC270.6 (1C0)
U_CF_IN_SRC_0: IC270.14 (A)
U_CF_IN_SRC_1: IC270.2 (B)
U_ESC_0: IC231.12 (Q5), IC256.2 (1A)
U_ESC_1: IC231.15 (Q6), IC256.5 (2A)
U_ESC_SRC: IC256.1 (!A!/B)
U_FETCH_0: IC34.4 (1C2)
U_FETCH_1: IC34.12 (2C2)
U_FETCH_2: IC35.4 (1C2)
U_FETCH_3: IC35.12 (2C2)
U_FETCH_4: IC36.4 (1C2)
U_FETCH_5: IC36.12 (2C2)
U_FETCH_6: IC37.4 (1C2)
U_FETCH_7: IC37.12 (2C2)
U_FETCH_8: IC38.4 (1C2)
U_FETCH_9: IC38.12 (2C2)
U_FETCH_10: IC40.4 (1C2)
U_FETCH_11: IC40.12 (2C2)
U_FETCH_12: IC73.4 (1C2)
U_FETCH_13: IC73.12 (2C2)
U_OF: IC15.13 (4B), IC127.2 (1A), IC231.9 (Q4)
U_OFFSET0: IC49.3 (1B)
U_OFFSET1: IC49.6 (2B)
U_OFFSET2: IC49.10 (3B)
U_OFFSET3: IC49.13 (4B)
U_OFFSET4: IC55.3 (1B)
U_OFFSET5: IC55.6 (2B)
U_OFFSET6: IC55.10 (3B), IC55.13 (4B), IC63.3 (1B), IC63.6 (2B), IC63.10 (3B), IC63.13 (4B), IC100.3 (1B), IC100.6 (2B)
U_OF_IN_SRC: IC127.1 (!A!/B)
U_SF: IC15.10 (3B), IC121.2 (1A), IC231.6 (Q3), IC_86_0.9 (I0)
U_SF_IN_SRC: IC121.1 (!A!/B)
U_TRAP_0: IC34.3 (1C3)
U_TRAP_1: IC34.13 (2C3)
U_TRAP_2: IC35.3 (1C3)
U_TRAP_3: IC35.13 (2C3)
U_TRAP_4: IC36.3 (1C3)
U_TRAP_5: IC36.13 (2C3)
U_TRAP_6: IC37.3 (1C3)
U_TRAP_7: IC37.13 (2C3)
U_TRAP_8: IC38.3 (1C3)
U_TRAP_9: IC38.13 (2C3)
U_TRAP_10: IC40.3 (1C3)
U_TRAP_11: IC40.13 (2C3)
U_TRAP_12: IC73.3 (1C3)
U_TRAP_13: IC73.13 (2C3)
U_ZF: IC15.3 (1B), IC231.2 (Q1), IC236.2 (I1), IC237.6 (1C0)
U_ZF_IN_SRC_0: IC237.14 (A)
U_ZF_IN_SRC_1: IC237.2 (B)
VCC: IC16.12 (D7), IC16.13 (D6), IC16.14 (D5), IC39.14 (4A), IC47.6 (1C0), IC49.2 (1A), IC58.4 (I1), IC74.2 (D), IC74.4 (PRE), IC74.10 (PRE), IC74.12 (D), IC104.2 (1A), IC104.5 (2A), IC107.2 (D), IC107.4 (PRE), IC107.10 (PRE), IC107.12 (D), IC108.2 (D), IC108.4 (PRE), IC108.10 (PRE), IC108.12 (D), IC126.1 (CLR), IC126.4 (PRE), IC137.2 (D), IC137.4 (PRE), IC137.10 (PRE), IC137.12 (D), IC164.6 (G1), IC187.30 (CE2), IC190.1 (CLR), IC190.4 (PRE), IC190.10 (PRE), IC190.13 (CLR), IC213.30 (CE2), IC231.1 (CLR), IC_10_0.4 (I1), INT_STATUS_REG.1 (CLR), R1.2, R2.2, R3.2, R4.2, R5.2, R6.2, R7.2, R8.2, R9.2, R10.2, R11.2, R12.2, R13.2, R14.2, R15.2, R16.2, R17.2, R18.2, R19.2, R20.2, R21.2, R22.2, R23.2, R24.2, R25.2, R26.2, R27.2, R28.2
W0: IC1.2 (1A), IC163.2 (A1), IC180.7 (1Y), IC198.3 (1D)
W1: IC1.5 (2A), IC163.4 (A2), IC180.9 (2Y), IC198.4 (2D)
W2: IC1.11 (3A), IC29.7 (1Y), IC163.6 (A3), IC198.7 (3D)
W3: IC1.14 (4A), IC29.9 (2Y), IC163.8 (A4), IC198.8 (4D)
W4: IC13.2 (1A), IC64.7 (1Y), IC163.11 (A1), IC198.13 (5D)
W5: IC13.5 (2A), IC64.9 (2Y), IC163.13 (A2), IC198.14 (6D)
W6: IC13.11 (3A), IC83.7 (1Y), IC163.15 (A3), IC198.17 (7D)
W7: IC13.14 (4A), IC83.9 (2Y), IC163.17 (A4), IC198.18 (8D)
WAIT: IC12.3 (D1)
WR: IC156.9 (I)
XBUS0: IC1.4 (1Y), IC10.2 (A0)
XBUS1: IC1.7 (2Y), IC10.23 (A1)
XBUS2: IC1.9 (3Y), IC10.21 (A2)
XBUS3: IC1.12 (4Y), IC10.19 (A3)
XBUS4: IC11.2 (A0), IC13.4 (1Y)
XBUS5: IC11.23 (A1), IC13.7 (2Y)
XBUS6: IC11.21 (A2), IC13.9 (3Y)
XBUS7: IC11.19 (A3), IC13.12 (4Y), IC_86_1.2 (I1), IC_86_1.4 (I0)
YBUS0: IC10.1 (B0), IC98.4 (1Y)
YBUS1: IC10.22 (B1), IC98.7 (2Y)
YBUS2: IC10.20 (B2), IC98.9 (3Y)
YBUS3: IC10.18 (B3), IC98.12 (4Y)
YBUS4: IC11.1 (B0), IC122.4 (1Y)
YBUS5: IC11.22 (B1), IC122.7 (2Y)
YBUS6: IC11.20 (B2), IC122.9 (3Y)
YBUS7: IC11.18 (B3), IC122.12 (4Y), IC_86_1.5 (I1)
ZBUFF2_16: IC24.14 (4A)
ZBUFF2_17: IC24.11 (3A)
ZBUFF2_18: IC24.5 (2A)
ZBUFF2_19: IC24.2 (1A)
ZBUFF2_20: IC7.14 (4A)
ZBUFF2_21: IC7.11 (3A)
ZBUFF2_22: IC7.5 (2A)
ZBUFF2_23: IC7.2 (1A)
ZBUS0: IC17.18 (Y1), IC25.1 (I0), IC129.2 (1A), IC131.2 (1A), IC241.3 (1C3)
ZBUS1: IC14.1 (D3), IC17.16 (Y2), IC25.2 (I1), IC129.5 (2A), IC131.5 (2A)
ZBUS2: IC17.14 (Y3), IC25.13 (I2), IC129.11 (3A), IC131.11 (3A), IC255.3 (1C3)
ZBUS3: IC17.12 (Y4), IC23.1 (D3), IC25.3 (I0), IC129.14 (4A), IC131.14 (4A)
ZBUS4: IC17.9 (Y1), IC25.4 (I1), IC128.2 (1A), IC132.2 (1A)
ZBUS5: IC17.7 (Y2), IC25.5 (I2), IC128.5 (2A), IC132.5 (2A)
ZBUS6: IC17.5 (Y3), IC25.9 (I0), IC128.11 (3A), IC132.11 (3A)
ZBUS7: IC17.3 (Y4), IC23.2 (D2), IC25.10 (I1), IC121.3 (1B), IC128.14 (4A), IC132.14 (4A), IC255.5 (1C1), IC_86_0.10 (I1), IC_86_1.1 (I0)
ZBUS_4: IC206.3 (1B)
ZBUS_5: IC206.6 (2B)
ZBUS_6: IC206.10 (3B)
ZBUS_7: IC206.13 (4B)
ZBUS_SRC_0: IC91.14 (A), IC95.14 (A), IC111.14 (A), IC113.14 (A)
ZBUS_SRC_1: IC91.2 (B), IC95.2 (B), IC111.2 (B), IC113.2 (B)
ZF_IN_SRC_0: IC241.14 (A)
ZF_IN_SRC_1: IC241.2 (B)
~ADDR_BUS_7_TO_14_ALLTRUE: IC168.4 (I2), IC203.8 (O), IC205.3 (I)
~BUS_TRISTATE: IC27.1 (G), IC154.8 (O), IC176.8 (O), IC218.1 (G), IC219.1 (G), IC222.1 (G), IC223.1 (G), IC224.1 (G), IC225.1 (G), IC228.1 (G), IC229.1 (G), IC230.1 (G)
~CLEAR_ALL_INTS: IC143.1 (I0), IC143.4 (I0), IC143.9 (I0), IC143.13 (I1), IC146.2 (I1), IC146.5 (I1), IC146.10 (I1), IC146.13 (I1), IC196.4 (O)
~RST: FLAGS.1 (CLR), IC32.1 (CLR), IC33.1 (CLR), IC115.6 (O)

Notes on the sheet:
ADDER
LOW
HIGH
U-ADDRESS
U-ADDRESS MUX
U_FLAGS
CONDITION SOURCE PROGRAMMER'S FLAGS OR U_CODE FLAGS
if type = branch, and condition = false, then next = +1
MSW_H
SINGLE STEP CLOCK
upper bits are a copy of u_offset6. this means this offset is a signed number from -64 to 63
to calculate OF when doing shifts we first save the sign of the original number, then when done shifting we save the value of the result. then we do a XOR of both values, and the result is the OF. the result of the XOR is the MSB of the result (ZBUS7). this is why wehave ZBUS7 as one of the inputs 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
ALU_0 IS WHAT THE CARRY FLAG BECOMES AFTER A SHIFT RIGHT OPERATION. WARNING: THIS IS NOT FROM THE ZBUS!! THIS IS BEFORE THE ALU'S OUTPUT IS SHIFTED!!
ALU_0 IS WHAT THE CARRY FLAG BECOMES AFTER A SHIFT RIGHT ALU_7 IS WHAT THE CF BECOMES AFTER A SHIFT-LEFT WARNING: THIS IS NOT FROM THE ZBUS!! THIS IS BEFORE THE ALU'S OUTPUT IS SHIFTED!!
PC_H
PC_L
BP_H
BP_L
SP_H
SP_L
MDR
ALU
CARRY IN MUX
ALU OUTPUT SHIFTED BY ONE
MARH
MARL
might want to feed the external data bus directly into MAR as well via a multiplexer. this is to speed-up RAM operations
MDR MUX
STATUS
SI_H
SI_L
DI_H
DI_L
LT LTE ~LT = GTE ~LTE + GT
SHL: MSB goes into CF. LSB replaced by 0 SLA: same as SHL ROL: LSB becomes MSB. RLC: MSB goes into CF. LSB becomes CF SHR: LSB goes into CF. MSB replaced by 0 SRA: LSB goes into CF. MSB is whatever the previous one was ROR: MSB becomes LSB RRC: MSB becomes CF. LSB goes into CF
DMA_ACK is also used to tri-state the buses when in DMA mode.
HALT: use the halt flag to tri-state all buses. do microcode loop to test for interrupts or DMA. if no interrupts or DMA then just perform tight loop of zero offset. when int or DMA appears, jump +1. next microinstr is pre-fetch type, so that int or DMA can be executed. PC will be pointing to after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
000 = ZF 001 = CF 010 = SF 011 = OF 100 = S_L NEG: S_GE 101 = S_LE NEG: S_G 001 = U_L NEG: U_GE 110 = U_LE NEG: U_G
MICROCODE SEQUENCING
244 MICROCODE SIGNALS NEED INVERTER BECAUSE THEY GET RESET TO ZERO AT BEGINNING, AND 244 ARE LOW ACTIVE. THIS CAUSES PROBLEMS ON RESET.
Typ1Typ0 00 offset 01 branch 10 pre-fetch 11 post_fetch
MICROCODE 0 TO 63 IS RESERVED FOR CPU STARTUP. FETCH AT 0x10 TRAP AT 0x20
INT MASKS
PTB
0 = KERNEL 1 = USER
SSP_H
SSP_L
alu_op == add
ALU_OP == SUB
alu_mode removed. OF is undefined if alu in logic mode anyway.
THIS COMES FROM THE MICROCODE BOARD BUT IS NOT A CONTROL BIT. IT IS A COMBINATION OF TWO BITS.
FRONT PANEL REGISTER DISPLAY
INT_PENDING input to conditional is to be used with HALT instruction to check if ints are pending. It is also used with the CPU trace mode so that when coming out of the TRACE microcode loop, we can jump to the interrupts handler if interrupts are pending. Without the INT_PENDING conditional it is 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
TDR
74HC32 at AY20
SHOULD ADD RESISTOR HERE AT CLOCK SELECT OUTPUT BECAUSE IF CLOCK FLOATS, IT COULD MAKE STOP_CLOCK SIGNAL META STABLE
used for sign extension
G_L
G_H
I NEED TO ADD LOGIC SO THAT UART ONLY ACTIVATES IF AD21 TO AD16 ARE ZERO BECAUSE THAT IS THE IO AREA FOR WHEN PAGING IS ON
removed trace_mode flag from here. (no longer exists)
REWIRING THE A1/A27 OF THE ROMS WILL BE DIFFICULT AND COULD DAMAGE THE WIRING AND DESTROY THE BOARD.
add mux here to create ESC OPCODE
FORGOT WHAT THIS IS... ADDRESS BANKING PERHAPS?
512KB RAM MODULES. 8 MODULES GIVING A TOTAL OF 4MB
