abaffa/sol-1/(commit log)

2022-12-17 initial commit of SystemVerilog RTL for Modelsim.
    [main.sch, verilog.psm]
2022-12-17 sv updates
    [verilog.psm]
2022-12-18 SystemVerilog model updates
    [verilog.psm]
2022-12-18 added kicad schematics
    [main.csv, main.sch, verilog.psm]
2022-12-18 changed c compiler folder name
    [a.obj]
2022-12-19 sv model updates
    [verilog.psm]
2022-12-21 added sol-1 web page
    [advent.obj, asm.obj, automaton.obj, bios.obj, boot.obj, cat.obj, chmod.obj, clr.obj]
2023-01-07 general updates
    [a.obj, advent.obj, asm.obj, automaton.obj, bios.obj, boot.obj, cat.obj, cf.obj]
2023-02-09 simu.exe updates
    [find.obj, sim.obj, simu.obj, unit_prompt.obj]
2023-02-21 added notes.txt
    [mkbin.obj]
2023-03-21 added symlinks
    [a.obj]
